Seeed-Projects/reBot-DevArm/README.md

<div align="center">

# 🦾 reBot Arm Base Series

**The Open-Source Robotic Arm for Every Developer**

reBot-DevArm Banner

<a href="https://certification.oshwa.org/cn000024.html">OSHWA Certified</a>








**100% Open Source · Embodied AI · Full Hardware + Software Stack**

🌐 [Landing Page](https://279070161-sketch.github.io/reBot/) · 📚 [Tutorial Center](https://wiki.seeedstudio.com/robotics_page/) · ▶ [Online Demo](https://seeed-projects.github.io/reBot_RS_Sim) · 🤖 [New: Bimanual reBot Arm T701](https://github.com/Seeed-Projects/reBot-Arm-T701)




[简体中文](README_zh.md) · [English](README.md) · [日本語](README_JP.md) · [français](README_Fr.md) · [Español](README_es.md)

</div>

---

## 📑 Contents

- [📖 Introduction](#-introduction)
- [🤖 Meet the Bimanual reBot Arm T701](#-meet-the-bimanual-rebot-arm-t701)
- [🛒 Get Your reBot Arm](#-get-your-rebot-arm)
- [🚀 Try the Online Simulation](#-try-the-online-simulation)
- [🗺️ Roadmap and Status](#%EF%B8%8F-roadmap-and-status)
- [⚙️ Hardware Specifications](#%EF%B8%8F-hardware-specifications)
- [🌟 Community Showcase](#-community-showcase)
- [🧹 Optional Hardware](#-optional-hardware)
- [🎓 Full-Stack Robotics Ecosystem](#-full-stack-robotics-ecosystem)
- [🙌 Acknowledgments and Contributors](#-acknowledgments-and-contributors)
- [📄 License](#-license)
- [☎ Contact Us](#-contact-us)

---

## 📖 Introduction

**reBot-DevArm** — the **reBot Arm B601-DM** and **reBot Arm B601-RS** — is a robotic arm project dedicated to lowering the barrier to learning Embodied AI. We believe in **true open source**: not just the code, but everything, released without reservation.

- 🦾 **Two arm models** — All design files for the **B601-DM (Damiao)** and **B601-RS (Robstride)**, two arms sharing the same appearance.
- 🛠️ **Hardware blueprints** — Source files for sheet-metal and 3D-printed parts.
- 🔩 **BOM list** — Detailed down to the spec and purchase link of every single screw.
- 💻 **Software & algorithms** — Python SDK, ROS1/2, Isaac Sim, LeRobot, and more.

## 🤖 Meet the Bimanual reBot Arm T701

<p align="center">
  <a href="https://github.com/Seeed-Projects/reBot-Arm-T701">reBot Arm T701 — open-source bimanual robotic platform</a>
</p>

After the B601, the community asked the obvious next question: *"Can it have two arms?"* The **[reBot Arm T701](https://github.com/Seeed-Projects/reBot-Arm-T701)** is our answer — an open-source bimanual platform for Physical AI, robot learning, and real-world data collection, carrying the B601's open-source legacy forward.

- 🦾 **Two 7-DOF arms + grippers on one torso** — One hand holds, the other operates.
- 📷 **Vision & compute ready** — Mounts for RealSense D405 wrist cameras, a D435 head camera, and a Jetson Orin.
- 🔓 **The same open-source promise** — CAD, BOM, SDK, and tutorials, released step by step.

> 🧪 The T701 is in **beta preview** and releasing in the open. ⭐ **[Star and watch the T701 repository](https://github.com/Seeed-Projects/reBot-Arm-T701)** to catch every release.

## 🛒 Get Your reBot Arm

| Model | Official Store | Other Channels |
| :--- | :--- | :--- |
| **reBot Arm B601-DM** | [SeeedStudio Bazaar](https://www.seeedstudio.com/reBot-Arm-B601-DM-Assembled-Kit-with-Power-Supply-Bundle.html) | [Amazon](https://www.amazon.com/dp/B0H2TWVFSW) · [AliExpress](https://de.aliexpress.com/item/1005012108314029.html) |
| **reBot Arm B601-RS** | [SeeedStudio Bazaar](https://www.seeedstudio.com/reBot-Arm-B601-RS-Bundle-p-6898.html) | [AliExpress](https://www.aliexpress.us/item/3256812343811970.html?gatewayAdapt=deu2usa4itemAdapt) |

### B601-DM Kit Options

Five kit options are available at [SeeedStudio.com](https://www.seeedstudio.com/reBot-Arm-B601-DM-Bundle.html):

- **[Arm Body Motor Kit](https://www.seeedstudio.com/reBot-Arm-B601-DM-Body-Motor-Kit-p-6752.html)** — Motors and wiring harnesses only.
- **[Arm Body Structural Kit](https://www.seeedstudio.com/reBot-Arm-B601-DM-Body-Structure-Kit-p-6753.html)** — Mechanical structural components only.
- **[Gripper Complete Kit](https://www.seeedstudio.com/reBot-Arm-B601-DM-Gripper-Kit-p-6751.html)** — Motors, wiring, and structure for the gripper.
- **[Full Kit](https://www.seeedstudio.com/reBot-Arm-B601-DM-Bundle.html)** — Complete arm body and gripper.
- **[Pre-assembled Robotic Arm](https://www.seeedstudio.com/reBot-Arm-B601-DM-Assembled-Kit-with-Power-Supply-Bundle.html)** — Fully assembled, ready to use.

> 💡 The kit does not include a power adapter or C-clamps as standard, since you may power it with batteries or mount it on a custom DIY base. Get the official [B601-DM Power Adapter Kit](https://www.seeedstudio.com/Power-Adapter-Kit-for-reBot-Arm-B601-DM-p-6874.html), purchase a [power supply](https://www.seeedstudio.com/AC-DC-Power-Adapter-IEC-60320-C14-XT30-Female-24V-4-5A-1200mm-L190-W92-5-H36mm-p-6764.html) and [power cord](https://www.seeedstudio.com/reServer-AC-US-p-5052.html) separately, or see the Mean Well solution at the bottom of the [BOM](./hardware/reBot_B601_DM/readme.md#about-power-supply).

### B601-RS Kit Options

Five kit options are available at [SeeedStudio.com](https://www.seeedstudio.com/reBot-Arm-B601-RS-Disassembly-Kit-Version-with-Power-Supply-Bundle.html):

- **[Arm Body Motor Kit](https://www.seeedstudio.com/reBot-Arm-B601-RS-Body-Motor-Kit-p-6867.html)** — Motors and wiring harnesses only.
- **[Arm Body Structural Kit](https://www.seeedstudio.com/reBot-Arm-B601-RS-Body-Structure-Kit-p-6866.html)** — Mechanical structural components only.
- **[Gripper Complete Kit](https://www.seeedstudio.com/reBot-Arm-B601-RS-Gripper-Kit-p-6868.html)** — Motors, wiring, and structure for the gripper.
- **[Full Kit](https://www.seeedstudio.com/reBot-Arm-B601-RS-Disassembly-Kit-Version-with-Power-Supply-Bundle.html)** — Unassembled complete arm body and gripper.
- **[Pre-assembled Robotic Arm](https://www.seeedstudio.com/reBot-Arm-B601-RS-Bundle-p-6898.html)** — Fully assembled, ready to use.

> 💡 We recommend the [Mean Well 48V 12.5A](https://www.amazon.com/sspa/click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) power supply for the RS model. For full performance, opt for a 48V 25A adapter. For a plug-and-play option, get the official [B601-RS Power Adapter Kit](https://www.seeedstudio.com/Power-Adapter-Kit-for-reBot-Arm-B601-RS-p-6873.html).

### Optional Accessories

Optional add-ons available at [SeeedStudio.com](https://www.seeedstudio.com):

- **[Power Adapter Kit (B601-DM)](https://www.seeedstudio.com/Power-Adapter-Kit-for-reBot-Arm-B601-DM-p-6874.html)** — Official power adapter for the DM model.
- **[Power Adapter Kit (B601-RS)](https://www.seeedstudio.com/Power-Adapter-Kit-for-reBot-Arm-B601-RS-p-6873.html)** — Official power adapter for the RS model.
- **[Power Discharge Module (B601-DM)](https://www.seeedstudio.com/Rebotic-Power-Discharge-Module-for-reBot-Arm-B601-DM-p-6988.html)** — Circuit protection and emergency stop for the DM model.
- **[Bleeder Module (B601-RS)](https://www.seeedstudio.com/Rebotic-Bleeder-Module-for-reBot-Arm-B601-RS-p-6987.html)** — Circuit protection and emergency stop for the RS model.
- **[Soft Gripper](https://www.seeedstudio.com/reBot-Soft-Gripper-p-6989.html)** — Flexible gripper compatible with both models.

### Leader Arm (Optional)

Purchase the [Leader Arm](https://www.seeedstudio.com/Star-Arm-102-p-6765.html?qid=P2U7IG_yskyak5m_1776415593315) and a [12V 10A power supply](https://www.seeedstudio.com/FY1209900-12V-10A-Power-Adapter-12V-10A-p-6496.html); the 12V DC adapter of the SO-ARM101 also works.

## 🚀 Try the Online Simulation

Experience the reBot Arm B601-RS MuJoCo digital twin directly in your browser — no installation required. Switch between the standard arm and AGV configurations, control joints and TCP, view the overhead and D405 wrist cameras, and run the automated put-away and stacking demos. The initial model download may take a moment; Chrome or Edge is recommended.

<p align="center">
  <a href="https://seeed-projects.github.io/reBot_RS_Sim"><strong>▶ Launch the reBot Arm Interactive Demo</strong></a>
</p>

## 🗺️ Roadmap and Status

We continuously maintain and adapt to mainstream robot development ecosystems. Below is our current progress and release plan.

### reBot Arm B601-DM

| Ecosystem | Status | Description | Documentation |
| :--- | :---: | :--- | :--- |
| Basic Motor Usage | ✅ Done | Motion control and API encapsulation | [Damiao Technology](https://wiki.seeedstudio.com/cn/damiao_series/) |
| STEP 3D Parts & BOM | ✅ Done | STEP files, parts BOM, and reference prices | [reBot Arm B601-DM BOM](./hardware/reBot_B601_DM/readme.md) |
| Real-Machine Performance Testing | ✅ Done | Performance under normal and extreme conditions | [Performance Testing](./hardware/reBot_B601_DM/performance_testing/Performance_Testing.md) |
| Assembly Video | ✅ Done | Ultra-detailed assembly steps and video | [Getting Started](https://wiki.seeedstudio.com/rebot_b601_dm_getting_started/) |
| Python SDK | ✅ Done | One-stop motor read/write & control (Robstride, Damiao, Mota, Gaoqing, Hexfellow…) | [Motorbridge](https://motorbridge.seeedstudio.com) · [Web UI](https://rebot-devarm.w0x7ce.eu/) |
| ROS2 Integration | ✅ Done | Kinematics, trajectory planning, gravity compensation | [ROS2 Guide](https://wiki.seeedstudio.com/rebot_arm_b601_dm_ros2_integration/) |
| Pinocchio Integration | ✅ Done | Forward/inverse kinematics and gravity compensation | [Pinocchio Guide](https://wiki.seeedstudio.com/rebot_arm_b601_dm_pinocchio_meshcat/) · [Repo](https://github.com/Seeed-Projects/reBotArm_control_py) |
| Isaac Sim Simulation | ✅ Done | USD models and simulated teleoperation | [Wiki](https://wiki.seeedstudio.com/rebot_arm_b601_dm_isaacsim/) |
| VR Teleoperation | ✅ Done | PICO 4 VR-based bilateral teleoperation | [Repo](https://github.com/Eaglewzw/lerobot-teleoperator-rebot-vr) |
| LeRobot Integration | ✅ Done | Hugging Face LeRobot training framework | [LeRobot Guide](https://wiki.seeedstudio.com/rebot_arm_b601_dm_lerobot/) |
| Depth Camera Integration | ✅ Done | YOLO + depth camera visual grasping demo | [Grasping Demo](https://wiki.seeedstudio.com/rebot_arm_b601_dm_grasping_demo/) |
| reSpeaker Voice Integration | ✅ Done | reSpeaker Flex 4-mic array, voice-driven control with spatial awareness | [Voice Control](https://wiki.seeedstudio.com/control_rebot_arm_using_voice_with_respeaker_flex/) |
| Latest Algorithms | ⏳ Planned | Mainstream algorithms updated progressively | Ongoing |
| Free Course Series | ⏳ Planned | A series of completely free courses | Ongoing |

#### Community Contributions

| Ecosystem | Author | Description | Repository |
| :--- | :---: | :--- | :--- |
| ROS2 (Humble), third-party integration, URDF / rebotarm_bringup | [@danieldoradotalaveron-rb](https://github.com/danieldoradotalaveron-rb) | 1. **Passive diagnostics monitor** (`rebotarm_monitor_ros2`) — `/diagnostics` overlay for `rqt_robot_monitor`, serial/CAN-aware aggregator;<br>2. **Safe park & shutdown** — capture rest pose on connect, slow return on shutdown or `/rebotarm/park`;<br>3. **Gravity compensation (smooth stop)** — MIT ramp-out to eliminate clack and jerk during pos/vel handoff;<br>4. **Gamepad teleop with IK/FK & safety** — end-effector control via IK, live RViz visualization (simulation-only test);<br>5. **D405 eye-in-hand TF** — Xacro under `end_link` for RViz visualization & TF only. | [rebotarm_monitor_ros2](https://github.com/danieldoradotalaveron-rb/rebotarm_monitor_ros2) · [reBotArmController_ROS2](https://github.com/danieldoradotalaveron-rb/reBotArmController_ROS2) |

### reBot Arm B601-RS

| Ecosystem | Status | Description | Documentation |
| :--- | :---: | :--- | :--- |
| Basic Motor Usage | ✅ Done | Motion control and API encapsulation | [Robstride](https://wiki.seeedstudio.com/cn/robstride_control/) |
| STEP 3D Parts & BOM | ✅ Done | STEP files, parts BOM, and reference prices | [reBot Arm B601-RS BOM](./hardware/reBot_B601_RS/README.md) |
| Getting Started | ✅ Done | Quick start for the B601-RS | [Getting Started](https://wiki.seeedstudio.com/rebot_b601_rs_getting_started/) |
| Assembly Video | ✅ Done | Ultra-detailed assembly steps and video | [Assembly Video](https://wiki.seeedstudio.com/rebot_b601_rs_getting_started/) |
| ROS2 (Humble) | ✅ Done | Kinematics, trajectory planning, gravity compensation, MoveIt2 | [ROS2 Guide](https://wiki.seeedstudio.com/rebot_arm_b601_rs_ros2_integration/) |
| LeRobot Integration | ✅ Done | Hugging Face LeRobot training framework | [LeRobot Guide](https://wiki.seeedstudio.com/rebot_arm_b601_rs_lerobot/) |
| Pinocchio Integration | ✅ Done | Forward/inverse kinematics and gravity compensation | [Pinocchio Guide](https://wiki.seeedstudio.com/rebot_arm_b601_rs_pinocchio_meshcat/) · [Repo](https://github.com/Seeed-Projects/reBotArm_control_py) |
| Depth Camera Integration | ✅ Done | YOLO + depth camera visual grasping demo | [Grasping Demo](https://wiki.seeedstudio.com/rebot_arm_b601_rs_grasping_demo/) |
| Embodied Agent Architecture | ✅ Done | Accepts natural-language commands (e.g. "pick up the red block"), auto-plans and executes grasping | [Design](https://wiki.seeedstudio.com/wrc_demo_tutorial/) · [Source](https://github.com/TheMoonAstronaut/wrc.git) |
| Isaac Sim Simulation | ✅ Done | USD models and simulated teleoperation | [DLI Course](https://www.seeedstudio.com/sim-to-real-with-seeed-rebot-and-nvidia-isaac) · [Repo](https://github.com/Seeed-Projects/reBot-Isaacsim) |
| Latest Algorithms | ⏳ Planned | Mainstream algorithms updated progressively | Ongoing |
| Free Course Series | ⏳ Planned | A series of completely free courses | Ongoing |

#### Community Contributions

| Ecosystem | Author | Description | Repository |
| :--- | :---: | :--- | :--- |
| iPhone, HEBI Mobile I/O and Meta Quest teleoperation | [@ammarjmahmood](https://github.com/ammarjmahmood) | Move a phone or a Quest controller and the gripper follows, using the relative pose mapping from TidyBot++ (CoRL 2024): native SwiftUI and ARKit iPhone app, HEBI Mobile I/O, WebXR passthrough on Quest, a 200 Hz MIT driver with gravity feedforward, IK on the official RS URDF and safety interlocks. Tested on a B601-RS with an iPhone 16 Pro Max. | [rebot-phone-teleop](https://github.com/ammarjmahmood/rebot-phone-teleop) |
| Handheld HMI, Zephyr RTOS / CAN / ROS 2 | [@xiayip](https://github.com/xiayip) | A handheld terminal for reBot Arm RS with live joint telemetry, encoder-based position control, damping/impedance modes, hand-guided trajectory recording and replay, persistent Flash storage, and ROS 2 controller-switch requests. | [reBot_Arm_HMI](https://github.com/xiayip/reBot_Arm_HMI) · [Video demo](https://www.bilibili.com/video/BV1MNnw6gEEe/) |

## ⚙️ Hardware Specifications

Designed for desktop Embodied AI applications, balancing payload and flexibility.

| Parameter | reBot Arm B601-DM | reBot Arm B601-RS |
| :--- | :--- | :--- |
| Payload | 1.5 kg | **2.5 kg** |
| Recommended Workspace | 70% of arm reach | 70% of arm reach |
| Max Reach | 767 mm | **754 mm** |
| Weight | **≈ 4.5 kg** | ≈ 6.7 kg |
| Repeatability | < ±0.2 mm | < ±0.1 mm |
| Degrees of Freedom | 6 DOF + 1 Gripper | 6 DOF + 1 Gripper |
| Supported Ecosystems | ROS1, ROS2, LeRobot, Pinocchio, Isaac Sim, Python SDK | ROS1, ROS2, LeRobot, Pinocchio, Isaac Sim, Python SDK |
| Supply Voltage | DC 24V | DC 48V |

## 🌟 Community Showcase

|  |  |  |  |  |
| :---: | :---: | :---: | :---: | :---: |
| <a href="https://www.kaggle.com/competitions/gemma-4-good-hackathon/writeups/new-writeup-1778618527713">GEM-4</a><br><sub>[GEM-4](https://www.kaggle.com/competitions/gemma-4-good-hackathon/writeups/new-writeup-1778618527713)</sub> | <a href="https://x.com/Linyan_Fu/status/2056383947341525180">Linyan Fu</a><br><sub>[Linyan Fu](https://x.com/Linyan_Fu/status/2056383947341525180) · [Apheth D Almeida](https://x.com/Apheth_DAlmeida/status/2053503164507476096)</sub> | <a href="https://x.com/DhruvDiddi/status/2046605015008383284">Dhruv Diddi</a><br><sub>[Dhruv Diddi](https://x.com/DhruvDiddi/status/2046605015008383284)</sub> | <a href="https://x.com/ed0henderson/status/2055076839002095743">Ed Henderson</a><br><sub>[Ed Henderson](https://x.com/ed0henderson/status/2055076839002095743)</sub> | Sameer<br><sub>Sameer</sub> |
| <a href="https://x.com/pham_blnh/status/2061994096374505710">Binh Pham</a><br><sub>[Binh Pham](https://x.com/pham_blnh/status/2061994096374505710)</sub> | <a href="https://www.instagram.com/reel/DY7Ny8OPjVu/?utm_source=ig_web_copy_link&igsh=NTc4MTIwNjQ2YQ==">FangTianChongHui</a><br><sub>[FangTianChongHui](https://www.instagram.com/reel/DY7Ny8OPjVu/?utm_source=ig_web_copy_link&igsh=NTc4MTIwNjQ2YQ==)</sub> | <a href="https://x.com/dong1505lin">Xense YaoLin Dong</a><br><sub>[Xense YaoLin Dong](https://x.com/dong1505lin)</sub> | <a href="https://x.com/ed0henderson/status/2055076839002095743">Ed Henderson</a><br><sub>[Ed Henderson](https://x.com/ed0henderson/status/2055076839002095743)</sub> | <a href="https://x.com/yoshikai_man/status/2079938975398244705">yoshikai_man</a><br><sub>[yoshikai_man](https://x.com/yoshikai_man/status/2079938975398244705)</sub> |
| <a href="https://github.com/lipengdong/hei-rebot-lift">hei-rebot-lift</a><br><sub>[hei-rebot-lift](https://github.com/lipengdong/hei-rebot-lift)</sub> | <a href="https://www.linkedin.com/posts/activity-7484390995862781952-TX4m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">Martin Kemka</a><br><sub>[Martin Kemka](https://www.linkedin.com/posts/activity-7484390995862781952-TX4m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)</sub> | <a href="https://www.linkedin.com/posts/kamil-buczy%C5%84ski-102843301_seeedstudio-rebotarm-seeedprojectofthemonth-ugcPost-7485297094715461633-RV_6/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">Kamil Buczyński</a><br><sub>[Kamil Buczyński](https://www.linkedin.com/posts/kamil-buczy%C5%84ski-102843301_seeedstudio-rebotarm-seeedprojectofthemonth-ugcPost-7485297094715461633-RV_6/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)</sub> | <a href="https://www.linkedin.com/posts/doradodaniel_computervision-spatialai-sim2real-share-7474727487374184448-NhwX/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">Daniel Dorado</a><br><sub>[Daniel Dorado](https://www.linkedin.com/posts/doradodaniel_computervision-spatialai-sim2real-share-7474727487374184448-NhwX/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)</sub> | <a href="https://www.linkedin.com/posts/asierarranz_nvidia-physicalai-isaaclab-ugcPost-7480271721942417408-YNwu/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">Asier</a><br><sub>[Asier](https://www.linkedin.com/posts/asierarranz_nvidia-physicalai-isaaclab-ugcPost-7480271721942417408-YNwu/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)</sub> |
| <a href="https://x.com/thermalpastor/status/2103842737032458567">H</a><br><sub>[H](https://x.com/thermalpastor/status/2103842737032458567)</sub> | <a href="https://x.com/Alpha10six/status/2103860758559994216">alpha_rover</a><br><sub>[alpha_rover](https://x.com/Alpha10six/status/2103860758559994216)</sub> | <a href="https://x.com/DilumSanjaya/status/2102806161728885145">Dilum Sanjaya</a><br><sub>[Dilum Sanjaya](https://x.com/DilumSanjaya/status/2102806161728885145)</sub> | <a href="https://x.com/pham_blnh/status/2101003855731593544">Binh</a><br><sub>[Binh](https://x.com/pham_blnh/status/2101003855731593544)</sub> | <a href="https://x.com/LeRobotHF/status/2104519372333048112">LeRobot</a><br><sub>[LeRobot](https://x.com/LeRobotHF/status/2104519372333048112)</sub> |
| <a href="https://x.com/raghav2956/status/2104659668375339475">Raghav Kumar</a><br><sub>[Raghav Kumar](https://x.com/raghav2956/status/2104659668375339475)</sub> | <a href="https://www.linkedin.com/posts/kamil-buczy%C5%84ski-102843301_seeedstudio-ai-agent-ugcPost-7510738285707776000-1SMQ/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">Kamil Buczyński</a><br><sub>[Kamil Buczyński](https://www.linkedin.com/posts/kamil-buczy%C5%84ski-102843301_seeedstudio-ai-agent-ugcPost-7510738285707776000-1SMQ/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)</sub> | <a href="https://www.linkedin.com/feed/update/urn:li:activity:7510701008885309440/">Fictionlab</a><br><sub>[Fictionlab](https://www.linkedin.com/feed/update/urn:li:activity:7510701008885309440/)</sub> | <a href="https://x.com/seeedstudio/status/2101965998954107303">box2bridge</a><br><sub>[box2bridge](https://x.com/seeedstudio/status/2101965998954107303)</sub> | <a href="https://x.com/seeedstudio/status/2095469352976003482">FangTianChongHui</a><br><sub>[FangTianChongHui](https://x.com/seeedstudio/status/2095469352976003482)</sub> |
| <a href="https://www.youtube.com/watch?v=hZRDGHnXDnk">Kamil Buczynski</a><br><sub>[Kamil Buczynski](https://www.youtube.com/watch?v=hZRDGHnXDnk)</sub> | <a href="https://gxchris95.github.io/BetaGo/">BetaGo</a><br><sub>[BetaGo](https://gxchris95.github.io/BetaGo/)</sub> | <a href="https://x.com/dimentary/status/2104094838035820607">Dmytro Hrybov</a><br><sub>[Dmytro Hrybov](https://x.com/dimentary/status/2104094838035820607)</sub> | <a href="https://x.com/aamarsbarr/status/2106242900426449204">Ammar</a><br><sub>[Ammar](https://x.com/aamarsbarr/status/2106242900426449204)</sub> | <a href="https://x.com/KlausPetersen_X/status/2110514809318023386">Klaus Petersen</a><br><sub>[Klaus Petersen](https://x.com/KlausPetersen_X/status/2110514809318023386)</sub> |
| <a href="https://dreamlabs.ai/playground/#sim">dreamlabs</a><br><sub>[dreamlabs](https://dreamlabs.ai/playground/#sim)</sub> | <a href="https://www.bilibili.com/video/BV1MNnw6gEEe/">追风少年Patrick</a><br><sub>[追风少年Patrick](https://www.bilibili.com/video/BV1MNnw6gEEe/)</sub> | <a href="https://www.bilibili.com/video/BV1zPnq6oEhm/">虾烤实验室</a><br><sub>[虾烤实验室](https://www.bilibili.com/video/BV1zPnq6oEhm/)</sub> | <a href="https://www.bilibili.com/video/BV1YRnH6qE8B/">Goat_wzz</a><br><sub>[Goat_wzz](https://www.bilibili.com/video/BV1YRnH6qE8B/)</sub> | <a href="https://www.bilibili.com/video/BV1Tipb6DEn5/">W_Love_D</a><br><sub>[W_Love_D](https://www.bilibili.com/video/BV1Tipb6DEn5/)</sub> |
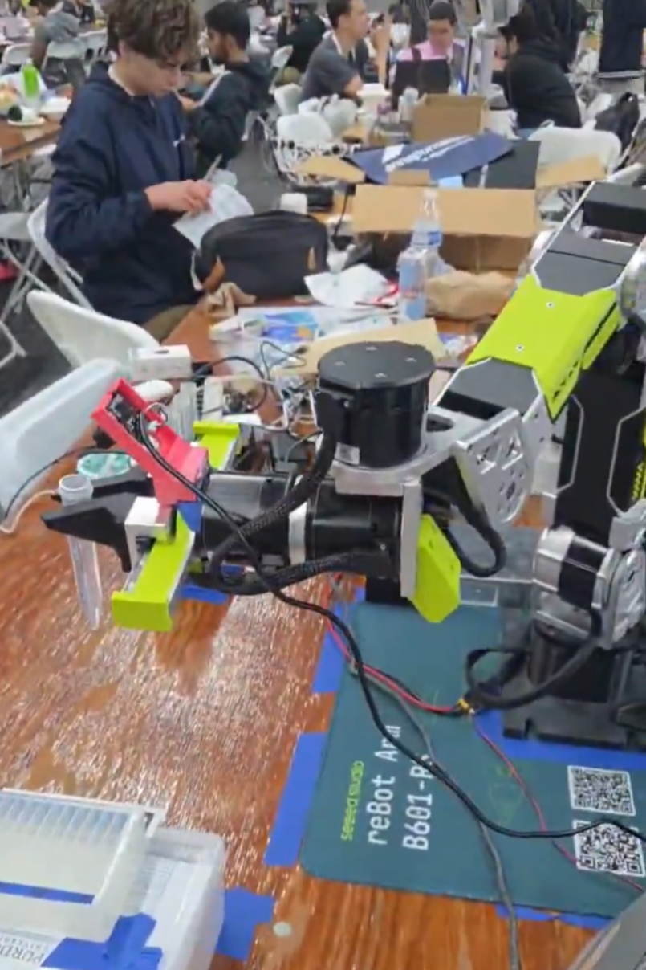
[picture p1: community/Amogh_Shrivastava.png]
Amogh Shrivastava
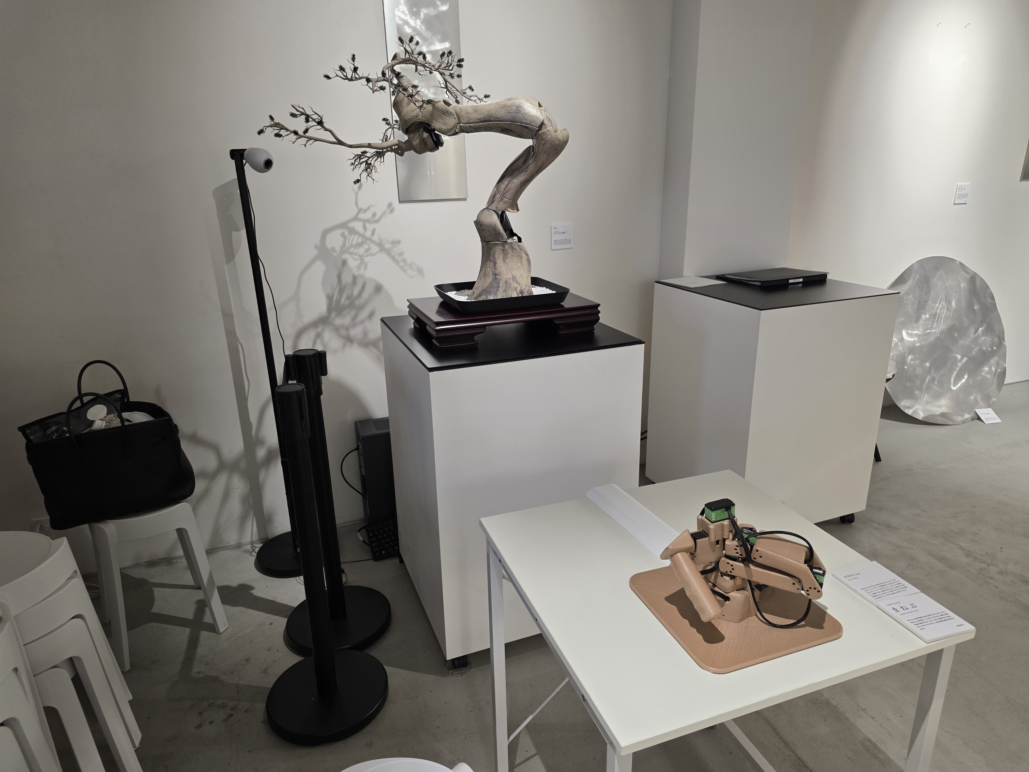
[picture p2: community/菊地あかね.jpg]
菊地あかね
| <a href="https://www.bilibili.com/video/BV1EvJR6iEuZ/">W_Love_D</a><br><sub>[W_Love_D](https://www.bilibili.com/video/BV1EvJR6iEuZ/)</sub> | <a href="https://x.com/yoshikai_man/status/2112946345548111958">yoshikai_man</a><br><sub>[yoshikai_man](https://x.com/yoshikai_man/status/2112946345548111958)</sub> | <a href="https://x.com/Mikeintech/status/2112604823170281688">Mike In Tech</a><br><sub>[Mike In Tech](https://x.com/Mikeintech/status/2112604823170281688)</sub> | <br><sub>[Amogh Shrivastava](https://x.com/stisov16/status/2114267861518868538)</sub> | <br><sub>[菊地あかね](https://x.com/akanekikuchi4/status/2078486766944928011)</sub> |

<p align="center">
  <a href="https://www.seeedstudio.com/sim-to-real-with-seeed-rebot-and-nvidia-isaac">Sim-to-Real VLA Course</a><br>
  <sub><a href="https://www.seeedstudio.com/sim-to-real-with-seeed-rebot-and-nvidia-isaac">Seeed reBot Arm × NVIDIA Isaac — Sim-to-Real VLA Course</a></sub>
</p>

## 🧹 Optional Hardware

### Wrist Camera Mount

These wrist camera mounts are shared by **B601-RS and B601-DM**. See the [complete camera mount and data collection catalog](hardware/camera-mounts/README.md) for all models, previews, and downloads.

| 32×32 UVC | Intel D435i | Intel D405 & Gemini 305 | Gemini 2 |
| :--- | :--- | :--- | :--- |
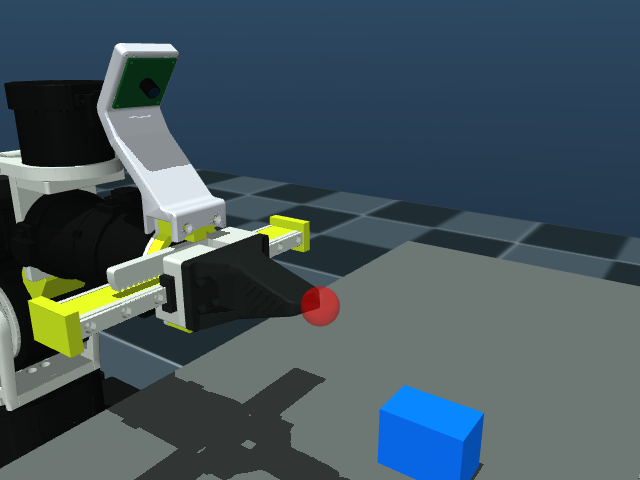
[picture p3: Rebot_Arm_description/Camera/images/uvc32-mujoco.png]
32×32 UVC MuJoCo wrist camera assembly
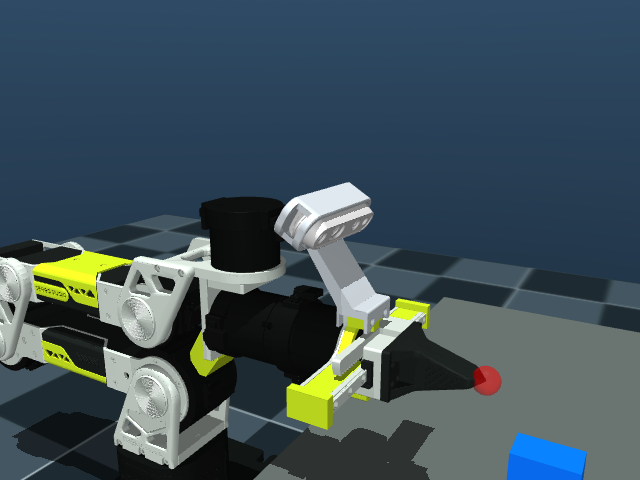
[picture p4: Rebot_Arm_description/Camera/images/d435i-mujoco.png]
RealSense D435i MuJoCo wrist camera assembly
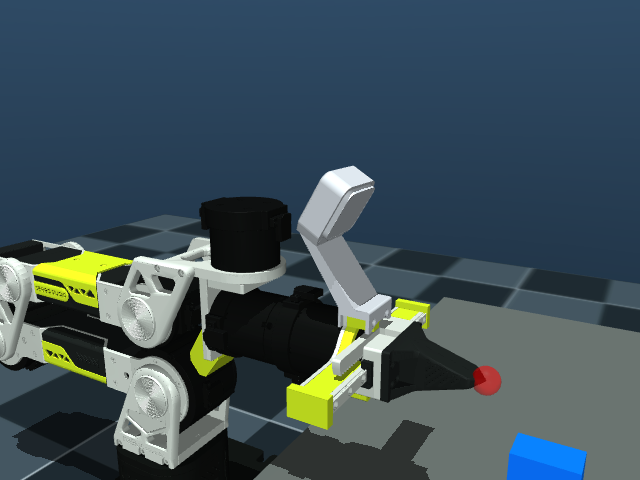
[picture p5: Rebot_Arm_description/Camera/images/d405-mujoco.png]
RealSense D405 MuJoCo wrist camera assembly
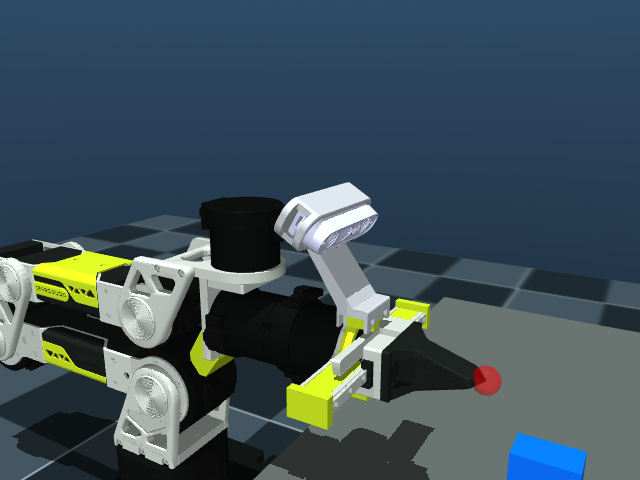
[picture p6: Rebot_Arm_description/Camera/images/gemini2-mujoco.png]
Orbbec Gemini 2 MuJoCo wrist camera assembly
|  |  |  |  |
| [STEP](hardware/camera-mounts/b601-camera-mounts/UVC32_mount.step) | [STEP](hardware/camera-mounts/b601-camera-mounts/D435_Gemini2_Mount.step) | [STEP](hardware/camera-mounts/b601-camera-mounts/D405_305_Mount.step) · [design notes](https://github.com/bowenszhu/rebot-b601-rs-d405-wrist-mount/tree/v1.0.0) | [STEP](hardware/camera-mounts/b601-camera-mounts/D435_Gemini2_Mount.step) |

The previews show UVC32, D435i, D405 and Gemini 2 assemblies on B601-RS; the mounts are shared with B601-DM. [URDFs and assembly instructions](Rebot_Arm_description/Camera/README.md). UVC32 uses the official bracket CAD with a schematic camera board.

### Leader Arm Compatibility

| Star Arm 102-LD | Open to compatibility integration |
| :--- | :--- |
|  | [Series Hub](https://fashionstar.com.hk/robot-arm/star-arm-102/) · [GitHub repo](https://github.com/servodevelop/Star-Arm-102) |

### DIY Soft Finger

| Soft Finger | Open to compatibility integration |
| :--- | :--- |
|  | Coming soon |
| [Finger Mount (ABS/PLA)](hardware/reBot_B601_DM/3D_Printed_Parts/Soft_Gripper/Soft_Gripper_Mount.step) · [Finger (TPU 95+)](hardware/reBot_B601_DM/3D_Printed_Parts/Soft_Gripper/Soft_Gripper_Finger.step) | Coming soon |
| Touch-Sensing Fin-Ray Gripper | **[Touch-Sensing Fin-Ray Gripper](https://github.com/StefanRohringer/Touch-Sensing-Fin-Ray-Gripper)** · [GitHub repo](https://github.com/StefanRohringer/Touch-Sensing-Fin-Ray-Gripper) |

### Recommended Optional Hardware

| Category | Type | Preview | Product | Link |
| :--- | :--- | :--- | :--- | :--- |
| **Camera** | Depth Camera | Orbbec Gemini 2 | **Orbbec Gemini 2 3D Camera** | [Seeed Studio](https://www.seeedstudio.com/Orbbec-Gemini-2-3D-Camera-p-6464.html) |
| **Camera** | Depth Camera | Orbbec Gemini 336 | **Orbbec Gemini 336 Depth Camera** | [Seeed Studio](https://www.seeedstudio.com/Orbbec-Gemini-336-3D-Camera-3D-p-6662.html) |
| **Camera** | Depth Camera | Orbbec Gemini 335LG | **Orbbec Gemini 335LG 3D Camera** | [Seeed Studio](https://www.seeedstudio.com/Orbbec-Gemini-335LG-3D-Camera-p-6541.html) |
| **Camera** | Depth Camera | SLAMTEC Aurora S | **SLAMTEC Aurora S** | [Seeed Studio](https://www.seeedstudio.com/SLAMTEC-Aurora-S-AI-Integrated-Spatial-Perception-System-p-6669.html) |
| **Camera** | Depth Camera | Intel RealSense D435i | **Intel RealSense Depth Camera D435i** | [Seeed Studio](https://www.seeedstudio.com/Intel-RealSense-Depth-Camera-D435i-p-4423.html) |
| **Camera** | Depth Camera | RealSense D405 | **RealSense Depth Camera D405** | [Seeed Studio](https://www.seeedstudio.com/RealSense-D405-3D-Camera-p-6758.html) |
| **Camera** | Monocular Camera | Sensing SG3S-ISX031C-GMSL2F | **Sensing SG3S-ISX031C-GMSL2F 3MP GMSL2 Camera** | [Seeed Studio](https://www.seeedstudio.com/SG3S-ISX031C-GMSL2F-p-6245.html) |
| **Camera** | Monocular Camera | ET-S231 | **ET-S231 Megapixel 120° Wide-Angle 1080P USB Camera** | [Seeed Studio](https://www.seeedstudio.com/ET-S231-120-USB-Camera-p-6683.html) |
| **Microphone** | Mic Array | reSpeaker Flex XVF3800 | **reSpeaker Flex XVF3800 Circular-4 with XIAO ESP32S3** | [Seeed Studio](https://www.seeedstudio.com/reSpeaker-Flex-XVF3800-Circular-4-with-XIAO-ESP32S3-p-6739.html) |
| **Microphone** | Mic Array | reSpeaker XMOS XVF3800 | **reSpeaker XMOS XVF3800** | [Seeed Studio](https://www.seeedstudio.com/ReSpeaker-XVF3800-USB-Mic-Array-p-6488.html) |
| **Controller** | Edge Controller | reComputer J3011 | **reComputer J3011-Orin Nano 8GB** | [Seeed Studio](https://www.seeedstudio.com/reComputer-J3011-p-5590.html) |
| **Controller** | Edge Controller | Jetson AGX Thor | **NVIDIA Jetson AGX Thor Developer Kit** | [Seeed Studio](https://www.seeedstudio.com/NVIDIA-Jetson-AGX-Thor-Developer-Kit-p-9965.html) |

## 🎓 Full-Stack Robotics Ecosystem

reBot-DevArm is not just a robotic arm — it is a robotics learning community. The following general tutorials are shared for free:

**🖥️ Edge Computing & Master Control**

-  — AI inference & compute core
-  — general Linux dev environment
-  — low-power wireless control node

**📡 Sensors & Peripherals**

- **Motors & Servos** — [Damiao / Gogo / Robstride / Mita / Feite / Fashion Star](https://wiki.seeedstudio.com/robotics_page/)
- **Visual Perception** — [Depth cameras / LiDAR / vision algorithms](https://wiki.seeedstudio.com/robotics_page/)
- **Voice Interaction** — [reSpeaker mic arrays / voice control / spatial awareness (DoA)](https://wiki.seeedstudio.com/control_rebot_arm_using_voice_with_respeaker_flex/)
- **Motion & Attitude** — [IMU (6/9-axis) / gyroscopes / magnetometers](https://wiki.seeedstudio.com/Sensor_accelerometer/)
- **Comprehensive Kits** — [more robotics sensors & driver examples](https://wiki.seeedstudio.com/robotics_page/)

> 👉 **[Enter the Wiki Knowledge Base](https://wiki.seeedstudio.com/)** — all tutorials are free to view.

## 🙌 Acknowledgments and Contributors

The path of open source is never lonely. The reBot-DevArm project would not exist without the support of Seeed Studio, the global open-source community, and our hardware partners.

**🌍 Ecosystem & Software Support**

- [Seeed Studio](https://www.seeedstudio.com/) — hardware supply chain and technical support
- [Hugging Face LeRobot](https://github.com/huggingface/lerobot) — end-to-end robot learning framework
- [NVIDIA Isaac Sim](https://developer.nvidia.com/isaac/sim) — robot simulation and synthetic data platform

**⚙️ Core Hardware Partners**

- [Damiao Technology](https://www.damiaokeji.com/)
- [Robstride](https://robstride.com/)
- [Fashion Star](https://fashionstar.com.hk/wiki/)

**💡 Inspiration**

- [SO-ARM100](https://github.com/TheRobotStudio/SO-ARM100/tree/main)
- [Mobile ALOHA](https://github.com/tonyzhaozh/aloha)
- [Dummy-Robot (Zhihui Jun)](https://github.com/peng-zhihui/Dummy-Robot)
- [OpenArm](https://openarm.dev/)
- [I2RT](https://i2rt.com/)
- [TRLC-DK1](https://github.com/robot-learning-co/trlc-dk1)

**🎃 Prototype Contributors**

- SeeedStudio AI Robotics Team — Yaohui Zhu (yaohui.zhu@seeed.cc)
- SeeedStudio STU — Wentao Dong
- SeeedStudio STU — Weiwei Xu
- SeeedStudio Purchasing Department — Fengqun Peng

**👥 Contributors**

<p align="center"><a href="https://github.com/Seeed-Projects/reBot-DevArm/graphs/contributors">
  
</a></p>

*Coming soon — welcome to submit PRs and become a contributor!*

### ⭐ Star History

<p align="center">
<picture>
  <source media="(prefers-color-scheme: dark)" srcset="assets/star-history/star-history-dark.svg">
  <source media="(prefers-color-scheme: light)" srcset="assets/star-history/star-history-light.svg">
  
</picture>
</p>

## 📄 License

- **Hardware Design** © 2026 Seeed Studio Co., Ltd. — open sourced under [CERN-OHL-W-2.0](https://ohwr.org/cern_ohl_w_v2.txt)
- **Firmware Code** © 2026 Seeed Studio Co., Ltd. — open sourced under [Apache-2.0](https://www.apache.org/licenses/LICENSE-2.0)

### Rights and Restrictions

The reBot Arm project has always followed the core philosophy of **agility, openness, responsibility, and symbiosis** to serve the developer community. Our vision is to let every enthusiast master the hardware architecture and software principles of robotic arms, and experience cutting-edge embodied-intelligence algorithms through reBot.

For the first five months after launch, the project used the **CC BY-SA NC (Non-Commercial)** license, so developers could focus on iterating and improving the product during its early phase. After months of polishing, **effective May 11, 2026**, the project transitioned to the **CERN-OHL-W 2.0** open-source license, achieving **100% full-stack open source (hardware and software) with full commercial-compliance and usage rights for all scenarios**.

Hardware and software use different licenses — please confirm the terms applicable to the part you use.

| Item | Hardware (CERN-OHL-W-2.0) | Software SDK (Apache-2.0) |
| :--- | :--- | :--- |
| ✅ Commercial Use | ✅ Allowed | ✅ Allowed |
| ✅ Modification | ✅ Allowed | ✅ Allowed |
| ✅ Redistribution | ✅ Allowed | ✅ Allowed |
| ✅ Closed-source Integration | ❌ Conditional (see [CERN-OHL-W-2.0](https://ohwr.org/cern_ohl_w_v2.txt)) | ✅ Allowed (no disclosure required) |
| ⚠️ Copyright Retention | ✅ Required | ✅ Required |
| ⚠️ License Text Retention | ✅ Required | ✅ Required |
| ⚠️ Modification Notice | ✅ Required (date + description) | ✅ Required (description) |
| ⚠️ Patent Grant | ✅ Explicit | ✅ Explicit |
| ⚠️ Source Provision on Distribution | ✅ Must provide "Complete Source" | ❌ Not required |
| ⚠️ External/Closed Module Compatibility | ✅ Allowed (Weakly Reciprocal) | ✅ Fully allowed |
| 🔗 Relation to Other Components | Independent interface modules (External Material) may stay closed | No restrictions |
| 📄 Official Full Text | [CERN-OHL-W-2.0](https://ohwr.org/cern_ohl_w_v2.txt) | [Apache-2.0](https://www.apache.org/licenses/LICENSE-2.0) |

## ☎ Contact Us

- **Open-Source Progress & Technical Support** — Yaohui: yaohui.zhu@seeed.cc
- **Future Collaboration & Customization** — Elaine: elaine.wu@seeed.cc
