Seeed-Projects/reBot-DevArm/hardware/reBot_B601_DM/readme_es.md

# 🤖 Especificación de hardware de código abierto de reBot DevArm

<p align="center">
  Banner de reBot-DevArm
</p>
<p align="center">
  <strong>
    <a href="./readme_zh.md">简体中文</a> &nbsp;|&nbsp;
    <a href="./readme.md">English</a> &nbsp;|&nbsp;
    <a href="./readme_jp.md">日本語</a>&nbsp;|&nbsp;
    <a href="./readme_fr.md">français</a>&nbsp;|&nbsp;
    <a href="./readme_es.md">Español</a>
  </strong>
</p>

| Fecha | Versión | Nombre del archivo | Registro de cambios |
|---|---|---|---|
|  2026-03-31 | v1.0 |  reBot_B601_DM_v1.0_20260331.step  | Subida inicial |
|  2026-04-25 | v1.1 |  reBot_B601_DM_v1.1_20260425.step  | Se añaden sujeciones de cables para los 3 motores de las articulaciones del extremo, para evitar que se aflojen y se desconecten. Se corrige el modelo de la articulación 1 de 4310 a 4340P. Se añade la pieza CNC 02_Base_Reinforcement_Part.step en la parte inferior para reforzar la rigidez de la base. |
|  2026-10-30 | v1.1 |  reBot_B601_DM_v1.1_20260625.step  | Todos los arneses de cables se han sustituido por arneses personalizados moldeados de mejor calidad; los dos soportes impresos en 3D del antebrazo y la muñeca se han ajustado internamente para que los cables puedan pasar por las posiciones de los orificios. |

Esta BOM corresponde al brazo robótico reBot Arm B601 DM, que utiliza motores de la serie 43 de Damiao. La otra versión, el reBot Arm B601 RS, utiliza motores RobStride; [consulta su BOM aquí](../reBot_B601_RS/README.md).

# 📦 Estructura de archivos
*   3D_Printed_Parts/: archivos STEP de todas las piezas impresas en 3D.
*   Metal_Parts/: archivos STEP de todas las piezas metálicas mecanizadas por CNC.
*   Purchased_Parts/: archivos STEP de todos los componentes comprados.
*   reBot_B601_DM_v1.1_20260625.step: archivo del ensamblaje completo del brazo robótico (versión actual).

# 🛒[Consigue todas las piezas](https://www.seeedstudio.com/reBot-Arm-B601-DM-Bundle.html)
- Ofrecemos cinco opciones de kit:
  - **Kit de motores del cuerpo del brazo**: incluye solo los motores y los arneses de cableado del brazo robótico.
  - **Kit estructural del cuerpo del brazo**: incluye solo los componentes estructurales mecánicos.
  - **Kit completo de la pinza (gripper)**: incluye los motores, los arneses de cableado y los componentes estructurales de la pinza.
  - **Kit completo**: incluye el conjunto completo del cuerpo del brazo robótico y la pinza.
  - **Brazo robótico premontado**: brazo robótico acabado y totalmente montado.

# 📊 Lista de materiales (BOM)

> [!WARNING]
> Aviso: la BOM publicada **no** representa la versión final que envía Seeed. Esta v1.1 de código abierto está optimizada para que los desarrolladores puedan reproducirla con el mínimo coste, con algunos detalles no esenciales simplificados.
> La versión final de producción de Seeed incluirá grabado láser en el metal para evitar errores de montaje (poka-yoke), algunas piezas impresas en 3D se sustituirán por metal para mayor durabilidad, las holguras y tolerancias de mecanizado se ajustarán a la variabilidad de fábrica (equilibrando precisión y coste) y se añadirá cableado personalizado (p. ej., protección con malla trenzada) con coste adicional. No obstante, la estructura mecánica es idéntica.

---

## 🖨️ Piezas impresas en 3D

| Descripción de la pieza | Imagen | Nombre del archivo | Material | Cant. | Notas |
|---|---|---|---|---|---|
| Plataforma base del brazo robótico |  | 01_BASE_Plate.step | ABS Bambu Lab negro | 1 | boquilla de 0.4 mm, altura de capa de 0.2 mm, relleno del 30% |
| Eslabón de la base del brazo robótico |  | 01_BASE_Link.step | ABS Bambu Lab negro | 1 | boquilla de 0.4 mm, altura de capa de 0.2 mm, relleno del 30% |
| Relleno izquierdo del brazo superior |  | 01_Upper_Arm_Fuller_L.step | PLA Bambu Lab negro y verde | 1 | boquilla de 0.4 mm, altura de capa de 0.2 mm, relleno del 15% |
| Relleno derecho del brazo superior |  | 01_Upper_Arm_Fuller_R.step | PLA Bambu Lab negro y verde | 1 | boquilla de 0.4 mm, altura de capa de 0.2 mm, relleno del 15% |
| Relleno central del brazo superior |  | 01_Upper_Arm_Fuller_M.step | ABS Bambu Lab negro | 1 | boquilla de 0.4 mm, altura de capa de 0.2 mm, relleno del 30% |
| Tope horizontal del brazo superior |  | 01_Upper_Arm_Limit.step | ABS Bambu Lab negro | 1 | boquilla de 0.4 mm, altura de capa de 0.2 mm, relleno del 30% |
| Asa del brazo |  | 01_Arm_Handle.step | ABS Bambu Lab negro | 1 | boquilla de 0.4 mm, altura de capa de 0.2 mm, relleno del 30% |
| Relleno izquierdo del brazo inferior |  | 01_Lower_Arm_Filler_L.step | PLA Bambu Lab negro y verde | 1 | boquilla de 0.4 mm, altura de capa de 0.2 mm, relleno del 15% |
| Relleno derecho del brazo inferior |  | 01_Lower_Arm_Filler_R.step | PLA Bambu Lab negro y verde | 1 | boquilla de 0.4 mm, altura de capa de 0.2 mm, relleno del 15% |
| Relleno central del brazo inferior |  | 01_Lower_Arm_Filler_M.step | ABS Bambu Lab negro | 1 | boquilla de 0.4 mm, altura de capa de 0.2 mm, relleno del 30% |
| Cubierta del brazo superior |  | 01_Upper_Arm_Cover.step | PLA Bambu Lab verde | 1 | boquilla de 0.4 mm, altura de capa de 0.2 mm, relleno del 15% |
| Cubierta del brazo inferior |  | 01_Lower_Arm_Cover.step | PLA Bambu Lab verde | 1 | boquilla de 0.4 mm, altura de capa de 0.2 mm, relleno del 15% |
| Cubierta de protección del motor 5 |  | 01_Motor_Cover.step | ABS Bambu Lab negro | 1 | boquilla de 0.4 mm, altura de capa de 0.2 mm, relleno del 30% |
| Tope horizontal de la pinza |  | 01_Lower_Arm_Limit.step | PLA Bambu Lab verde | 1 | boquilla de 0.4 mm, altura de capa de 0.2 mm, relleno del 15% |
| Soporte del carro de la pinza |  | 01-Rail-Bracket.step | PLA Bambu Lab verde | 1 | boquilla de 0.4 mm, altura de capa de 0.2 mm, relleno del 15% |
| Dedo de la pinza |  | 01_Finger.step | ABS Bambu Lab negro | 2 | boquilla de 0.4 mm, altura de capa de 0.2 mm, relleno del 45% |
| Sujeción de cables del motor 5 |  | 01_Joint5_Cable Restraint_A.step | PLA Bambu Lab verde | 1 | boquilla de 0.4 mm, altura de capa de 0.2 mm, relleno del 15% |
| Sujeción de cables A de los motores 6 y 7 |  | 01_Joint6_7_Cable Restraint_A.step | ABS Bambu Lab negro | 2 | boquilla de 0.4 mm, altura de capa de 0.2 mm, relleno del 30% |
| Sujeción de cables B de los motores 6 y 7 |  | 01_Joint6_7_Cable Restraint_B.step | ABS Bambu Lab negro | 2 | boquilla de 0.4 mm, altura de capa de 0.2 mm, relleno del 30% |
| - | Precio de referencia | Promedio **50 $** | | | El precio varía según el coste del material y el tiempo de impresión |

El roce continuado del arnés de cableado del motor 1 puede desgastar el conector del motor y provocar un mal contacto eléctrico. Imprimir las piezas que se indican a continuación puede mitigar este riesgo.

| Descripción de la pieza | Imagen | Nombre del archivo | Material | Cant. | Notas |
| ---- | ---- | ---- | ---- | ---- | ---- |
| Clips de arnés de cableado para ambos lados del motor 1 |  | `DM_Motor1_wiring_harness_clip.stp` | ABS Bambu Lab negro | 2 | boquilla de 0.4 mm, altura de capa de 0.2 mm, relleno del 30% |

## 📷 Soporte de cámara compatible

| Descripción de la pieza | Imagen | Nombre de archivo | Material | Cant. | Notas |
|---|---|---|---|---|---|
| [Orbbec Gemini2](https://www.seeedstudio.com/Orbbec-Gemini-2-3D-Camera-p-6464.html) |  | [`D435_Gemini2_Mount.step`](../camera-mounts/b601-camera-mounts/D435_Gemini2_Mount.step) | Bambu ABS Negro | 1 | Boquilla 0.4 mm, altura de capa 0.2 mm, relleno 30 % |

Los soportes de cámara de muñeca B601 son comunes a **B601-RS y B601-DM**. Los modelos, las vistas previas y las descargas están en el [catálogo compartido de soportes (en inglés)](../camera-mounts/README.md).

### 🧩 Recomendaciones de impresión
- Altura de capa: 0.2 mm
- Boquilla: 0.4 mm
- Soportes: añadir según sea necesario
- Materiales: las piezas sometidas a altas temperaturas y a carga se imprimen en ABS con un relleno del 30–80%; también pueden usarse nailon o materiales reforzados con fibra de carbono. Las piezas estéticas se imprimen en PLA con un relleno del 15%.
- Materiales recomendados para las piezas portantes: ABS con relleno del 30–80%, nailon o materiales reforzados con fibra de carbono

---

## 🔩 Piezas metálicas mecanizadas por CNC

> [!WARNING]
> Algunas piezas que pueden sustituirse por impresión 3D se indican en las notas, lo que puede reducir los costes considerablemente.

| Descripción de la pieza | Imagen | Nombre del archivo | Material | Cant. | Mecanizado | Notas |
|---|---|---|---|---|---|---|
| Soporte del rodamiento del motor 1 |  | 02_Base_Reinforcement_Part.step | Aleación de aluminio 5052 | 1 | CNC | Puede imprimirse en 3D en ABS con relleno alto para reducir el coste |
| Eje de rotación del motor 1 |  | 02_Arm_Yaw_Limit.step | Aleación de aluminio 5052 | 1 | CNC | Añade un límite de movimiento del ángulo de guiñada |
| Espaciador delantero de los motores 2–5 |  | 02_Motor_Front_Spacer.step | Aleación de aluminio 5052 | 4 | CNC | Puede imprimirse en 3D en ABS con relleno del 30% |
| Espaciador trasero de los motores 2–4 |  | 02_Motor_Back_Spacer.step | Aleación de aluminio 5052 | 3 | CNC | |
| Brida trasera de los motores 2–4 |  | 02_FLANGE.step | Aleación de aluminio 5052 | 3 | CNC | |
| Soporte del motor 5 de la muñeca |  | 02_Wrist_Bracket.step | Aleación de aluminio 5052 | 1 | CNC | |
| Conector A de la pinza |  | 02_Gripper_Connector_A.step | Aleación de aluminio 5052 | 1 | CNC | |
| Conector B de la pinza |  | 02_Gripper_Connector_B.step | Aleación de aluminio 5052 | 1 | CNC | |
| Soporte metálico del carro de la pinza |  | 02_Slider_Bracket.step | Aleación de aluminio 5052 | 1 | CNC | Puede imprimirse en 3D en ABS con relleno alto; no recomendado para uso prolongado |
| Extensión del carro a la pinza |  | 02_Slider_Extension.step | Aleación de aluminio 5052 | 2 | CNC | |
| Eslabón izquierdo entre brazo superior e inferior |  | 02_Lower_Upper_Link_L.step | Aleación de aluminio 5052 | 1 | CNC | |
| Eslabón derecho entre brazo superior e inferior |  | 02_Lower_Upper_Link_R.step | Aleación de aluminio 5052 | 1 | CNC | |
| Eslabón izquierdo entre brazo inferior y muñeca |  | 02_Lower_Wrist_Link_L.step | Aleación de aluminio 5052 | 1 | CNC | |
| Eslabón derecho entre brazo inferior y muñeca |  | 02_Lower_Wrist_Link_R.step | Aleación de aluminio 5052 | 1 | CNC | |
| Conector del engranaje |  | 02_Gear_Connector.step | Aleación de aluminio 5052 | 1 | CNC | |
| Cremallera |  | 02_Rack.step | Aleación de aluminio 5052 | 2 | CNC | |
| Eslabón 1 |  | 03_Link1.step | Aleación de aluminio 5052 | 1 | CNC + chapa metálica | |
| Eslabón 2 |  | 03_Link2.step | Aleación de aluminio 5052 | 2 | CNC + chapa metálica | |
| Eslabón 3 izquierdo |  | 03_Link3_L.step | Aleación de aluminio 5052 | 1 | CNC + chapa metálica | |
| Eslabón 3 derecho |  | 03_Link3_R.step | Aleación de aluminio 5052 | 1 | CNC + chapa metálica | |
| Eslabón 5 |  | 03_Link5.step | Aleación de aluminio 5052 | 1 | CNC + chapa metálica | |
| - | Precio de referencia de mercado | Promedio **250 $** | | | El precio varía según el coste del aluminio, los requisitos de tolerancia y el plazo de entrega |

### 🧩 Especificaciones de mecanizado
- Tolerancia de las cotas clave: ±0.02 mm GB/T1840-M
- Acabado superficial: anodizado / arenado
- Se recomienda usar H7 / ajuste por interferencia en las piezas de acoplamiento
---

## 🛒 Piezas compradas (piezas estándar)

> [!WARNING]
> Dado que cada uno tendrá que montar y apretar los tornillos por su cuenta, se han elegido tornillos Allen estándar. Tras un funcionamiento prolongado, los tornillos pueden aflojarse, lo que afectará a la precisión del brazo robótico. Por este motivo, debes comprar adicionalmente pegamento termofusible para fijar las roscas de los tornillos de cada articulación.

Si tienes un taladro eléctrico o herramientas similares, puedes optar por comprar arandelas de bloqueo o tornillos con freno de rosca. No obstante, **es sumamente importante** que uses el ajuste de par más bajo al utilizar un atornillador eléctrico para evitar que los tornillos se pasen de rosca, lo que provocaría daños irreversibles.

  | Nombre | Especificación / Modelo | Cantidad | Precio de referencia | Notas |
  |------|----------|------|----------|------|
  | Motor sin escobillas | DM4310(V4) | 4 | 120 $/unidad | [SeeedStudio](https://www.seeedstudio.com/Damiao-4310-Actuator-Motor-p-6823.html) |
  | Motor sin escobillas | DM4340P(V4) | 3 | 175 $/unidad |  [SeeedStudio](https://www.seeedstudio.com/DM4340P-Actuator-p-6663.html)  |
  | Placa driver CAN-USB |  | 1 | 15 $/unidad |   [SeeedStudio](https://www.seeedstudio.com/DM-CAN-USB-Driver-Borad-p-6706.html)   |
  | Rodamiento | 6707ZZ | 1 | 13 $/unidad | [Amazon](https://www.amazon.com/uxcell-35x44x5mm-Shielded-Precision-Lubricated/dp/B0D6WBMW3F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) |
  | Rodamiento | 6803ZZ | 3 | 13 $/unidad | [Amazon](https://www.amazon.com/uxcell-17x26x5mm-Shielded-Precision-Lubricated/dp/B0D54JSWBZ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) |
  | Rodamiento | AXK5578 | 1 | 12 $/unidad | [Amazon](https://www.amazon.com/PZRT-AXK5578-Thrust-Bearings-Washers/dp/B0B3M3RZGW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) |
  | Guía lineal | MGN9-170mm | 1 | 23 $/unidad | [Amazon](https://www.amazon.com/uxcell-Sliding-Carriage-Bearing-Printers/dp/B0D54L45WM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) |
  | Carro | MGN9 | 2 | 10 $/unidad | [Amazon](https://www.amazon.com/uxcell-Bearing-Sliding-Carriage-Anti-Fall/dp/B0D9QBQDKB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) |
  | Engranaje | Módulo 1, tipo cubo, 16 dientes, agujero de 6 mm | 1 | 44 $/unidad | [Amazon](https://www.amazon.com/Module-15-Teeth-Finished-Perforation/dp/B0GDSR1LKM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)  |
  | Almohadilla de silicona | 30x9x2mm | 1 | 10 $ | [Amazon](https://www.amazon.com/Self-Adhesive-Anti-Sliding-Anti-Scratch-Protectors-Appliances/dp/B0F9KVYXFZ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) |
  | Tornillo | Tornillo HM3-12mm | 14+ |  | [Amazon](https://www.amazon.com/BNUOK-120pcs-Stainless-Threads-Spanner/dp/B0DJQGMQZM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) |
  | Tornillo | Tornillo HM3-25mm | 14+ |  | [Amazon](https://www.amazon.com/BNUOK-120pcs-Stainless-Threads-Spanner/dp/B0DJQFGRPQ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)  |
  | Tornillo | Tornillo HM3-6mm | 16+ |  | [Amazon](https://www.amazon.com/BNUOK-120pcs-Stainless-Threads-Spanner/dp/B0DJQG5YLF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)  |
  | Tornillo | Tornillo prisionero HM4-75mm | 4+ |  | [Amazon](https://www.amazon.com/iexcell-Partially-Threaded-Thread-Socket/dp/B0DR1NX178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)  |
  | Tornillo | Tornillo KM3*12mm | 30+ |  |  [Amazon](https://www.amazon.com/Uxcell-a16011300ux0872-M3x12mm-Carbon-Countersunk/dp/B01E6EIC2S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) |
  | Tornillo | Tornillo KM3*16mm | 34+ |  | [Amazon](https://www.amazon.com/Uxcell-a16011300ux0872-M3x12mm-Carbon-Countersunk/dp/B01E6EIC2S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)  |
  | Tornillo | Tornillo KM3*7mm | 76+ |  |[Amazon](https://www.amazon.com/Uxcell-a16011300ux0872-M3x12mm-Carbon-Countersunk/dp/B01E6EIC2S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)   |
  | Tornillo | Tornillo KM3*9mm | 31+ |  |[Amazon](https://www.amazon.com/Uxcell-a16011300ux0872-M3x12mm-Carbon-Countersunk/dp/B01E6EIC2S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)   |
  | Tornillo | Tornillo KM3*8mm de cabeza baja con hueco hexagonal (Socket Micro Profile Head) | 31+ |  |[Amazon](https://www.amazon.com/SMALLRIG-Screw-Screws-12pcs-Pack/dp/B01MS60KSY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)   |
  | Tornillo | KA3*12mm | 72+ |  | [Amazon](https://www.amazon.com/uxcell-Phillips-Tapping-Screws-Silver/dp/B01MXSS95N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)  |
  | Pasador cilíndrico | M4*8mm | Varios |  | [Amazon](https://www.amazon.com/HARFINGTON-Stainless-Cylindrical-Furniture-Installation/dp/B0F6CWL4MP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)  |
  | Pasador cilíndrico | M4*12mm | Varios |  | [Amazon](https://www.amazon.com/HARFINGTON-Stainless-Cylindrical-Furniture-Installation/dp/B0F6CWL4MP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)  |
  | Juego de destornilladores | Juego de llaves hexagonales | 1 | 16 $  | [Amazon](https://www.amazon.com/Amazon-Basics-Ratcheting-Electronics-Screwdriver/dp/B07V4TFWFZ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)  |
  |  | XT30 2+2 350mm | 2 | 4 $/cable | Ambos extremos en ángulo |
  |  | XT30 2+2 350mm | 1 | 4 $/cable | Un extremo en ángulo y otro recto |
  |  | XT30 2+2 200mm | 3 | 4 $/cable | Ambos extremos en ángulo |
  |  | XT30 2+2 200mm | 1 | 3 $/cable | Ambos extremos rectos |

### Sobre la fijación
Puedes modificar libremente la base a partir de las piezas impresas en 3D que proporcionamos. También puedes usar sargentos en G según el grosor de tu mesa.

  | Nombre | Especificación / Modelo | Cantidad | Precio de referencia | Notas |
  |------|----------|------|----------|------|
  | Sargento de carpintería | Sargento en G de 6 pulgadas | 2 | 20 $/unidad | [Amazon](https://www.amazon.com/gp/aw/d/B092J1YW2M/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) |

### Sobre la alimentación
El brazo robótico se envía por defecto sin fuente de alimentación. Puedes conectar tu propia batería o comprar una fuente de alimentación MeanWell fiable de 24V 14.6A fabricada en Taiwán. Además, necesitarás comprar un enchufe de tres clavijas conforme a la normativa local y un arnés de cableado con conector XT30 hembra.

#### BOM de consumibles

| Nombre | Especificación | Cant. | Precio de referencia | Notas | Imagen |
|:---|:---|:---:|:---:|:---|:---:|
| Fuente de alimentación | LRS-350-24 (24V 14.6A) | 1 | 27.35 $ | [amazon](https://www.amazon.com/MEAN-WELL-LRS-350-24-350-4W-Switchable/dp/B013ETVO12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) |  |
| Cable de alimentación | Cable de CA estándar de EE. UU. | 1 | 4.49 $ | [amazon](https://www.amazon.com/LIFEPOE-Power-3-3ft-Black-3-Prong/dp/B0FK4KPW2G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) |  |
| Puerto de salida | Conector hembra fijo XT60E; XT60E hembra + terminal de ojal - 10cm; orificio del terminal de 4mm | 1 | 9.99 $ | [amazon](https://www.amazon.com/LINSYRC-XT60E-F-Connector-Battery-Quadcopter/dp/B0CQK1P1DP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) |  |
| Cableado de CA | 1.5mm²; rojo, azul y amarillo, 1 de cada (debes crimpar tú mismo los terminales al cable; no se incluyen cables precrimpados); 10CM | 3 | 0.99 $ | [aliexpress](https://www.aliexpress.com/item/1005008648016252.html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) |  |
| Base IEC 3 en 1 | Tipo de conexión rápida con interruptor rojo (doble tuerca) | 1 | 1.98 $ | [aliexpress](https://www.aliexpress.com/item/1005005962021242.html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) |  |
| Cable adaptador XT30 a XT60 | XT30U hembra a XT60 macho | 1 | 8.99 $ | [amazon](https://www.amazon.com/dp/B0BY8PSHK6?th=1) |  |
| Tornillo avellanado Phillips de acero inoxidable 304 | M4x6 | 6 | 0.37 $ | / | / |
| Tornillo avellanado Phillips de acero inoxidable 304 | M3x8 | 2 | 0.36 $ | / | / |
| Tornillo Phillips de cabeza alomada de acero inoxidable 304 | M3x8 | 2 | 0.32 $ | / | / |
| Tuerca hexagonal | M3x2.5 | 2 | ≈0.30 $ | / | / |

#### BOM de piezas impresas

| Nombre | Imagen | Cant. | Notas |
|:---|:---|:---:|:---|
| [Carcasa frontal](./3D_Printed_Parts/DM-power-Top%20Cover.stp) |  | 1 | PLA, boquilla de 0.4 mm, altura de capa de 0.2 mm, relleno del 30% |
| [Carcasa trasera](./3D_Printed_Parts/DM-power-Bottom%20Cover.stp) |  | 1 | PLA, boquilla de 0.4 mm, altura de capa de 0.2 mm, relleno del 30% |
| [Tapa deslizante de la carcasa frontal](./3D_Printed_Parts/DM-power-Top%20Cover-Sliding%20Cover.stp) |  | 1 | PLA, boquilla de 0.4 mm, altura de capa de 0.2 mm, relleno del 30% |

#### Montaje de la fuente de alimentación

El montaje de la fuente de alimentación se divide en dos secciones principales: la carcasa frontal y la carcasa trasera.

##### 1. Montaje de la carcasa frontal

| Paso | Instrucciones | Imagen | Notas |
|:---:|---|---|---|
| 1-1 | Prepara las piezas y los componentes impresos necesarios para el montaje de la carcasa frontal |  | Comprueba que todas las piezas estén completas |
| 1-2 | Consulta las indicaciones de la secuencia de cableado de cada pieza y monta siguiéndola | <br> | Sigue estrictamente la secuencia de cableado al conectar |
| 1-3 | Instala el conector XT60 |  | Fíjalo con tornillos avellanados Phillips de acero inoxidable 304 M3x8 y tuercas hexagonales M3x2.5 |
| 1-4 | Instala la base IEC 3 en 1 |  | Fija la base IEC 3 en 1 con tornillos Phillips de cabeza alomada de acero inoxidable 304 M3x8 |
| 1-5 | Cableado interno de la carcasa frontal | <br> | Comprueba las conexiones con el diagrama de la secuencia de cableado |
| 1-6 | Fija ambos lados de la carcasa frontal y la fuente de alimentación |  | Tornillos avellanados Phillips de acero inoxidable 304 M4x6 x2 |
| 1-7 | Instala la tapa deslizante |  | Introdúcela desde la parte inferior de la fuente de alimentación |
| 1-8 | Fija la tapa deslizante |  | Tornillos avellanados Phillips de acero inoxidable 304 M4x6 x2 |

---

##### 2. Montaje de la carcasa trasera

| Paso | Instrucciones | Imagen | Notas |
|:---:|---|---|---|
| 2-1 | Prepara las piezas y los componentes impresos necesarios para el montaje de la carcasa trasera |  | Comprueba que los accesorios estén completos |
| 2-2 | Monta la carcasa trasera con la fuente de alimentación |  | Alinea la posición |
| 2-3 | Fija ambos lados de la carcasa trasera y la fuente de alimentación |  | Tornillos avellanados Phillips de acero inoxidable 304 M4x6 x2 |

---

##### 3. Finalización del conjunto

| Paso | Instrucciones | Imagen | Notas |
|:---:|---|---|---|
| 1 | Montaje del sistema de alimentación completado |  | Comprueba que todos los tornillos estén apretados |

---
