Seeed-Projects/reBot-DevArm/hardware/camera-mounts/b601-camera-mounts/V1/D435_Gemini2_Mount.step

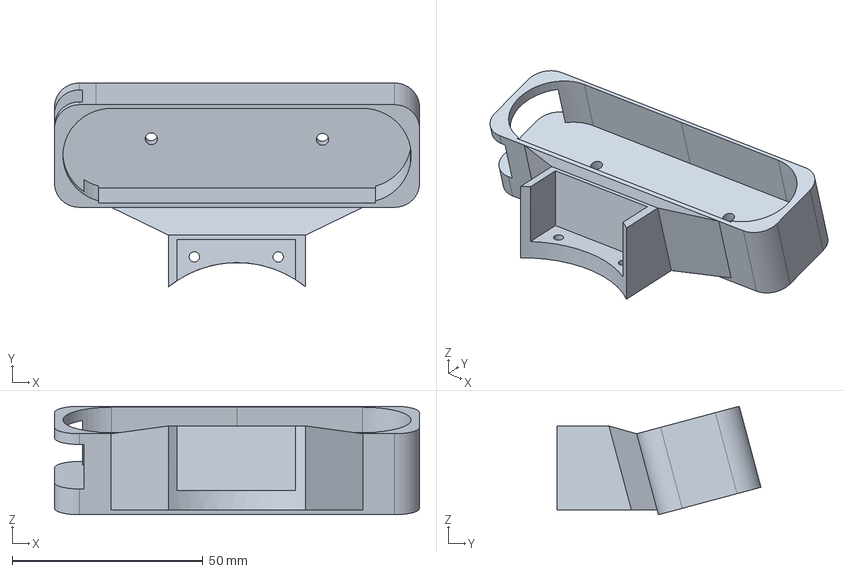
[picture p13: CAD file, 2026-11-11]
hardware/camera-mounts/b601-camera-mounts/V1/D435_Gemini2_Mount.step
95.8 x 53.5 x 28.5 mm
