Seeed-Projects/reBot-DevArm/hardware/camera-mounts/data-collection-camera-mounts/data-collection-camera-mount-v2.stp

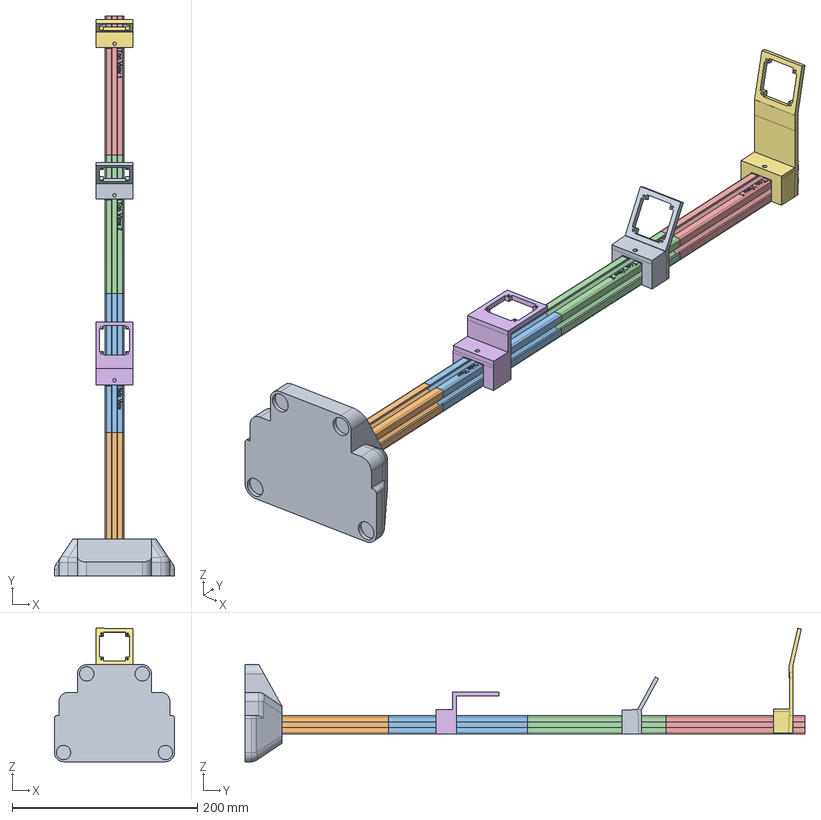
[picture p14: CAD file, 2026-10-09]
hardware/camera-mounts/data-collection-camera-mounts/data-collection-camera-mount-v2.stp
130.0 x 605.0 x 144.3 mm
4_2020_150MM0001
3_2020_150MM0001
2_2020_150MM0001
1_2020_150MM0001
