Seeed-Projects/reBot-DevArm/hardware/camera-mounts/data-collection-camera-mounts/V1/mount-1.stp

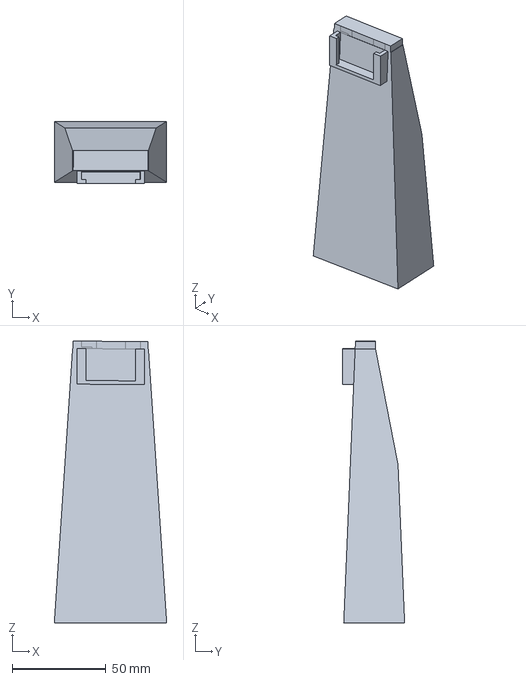
[picture p15: CAD file, 2026-10-09]
hardware/camera-mounts/data-collection-camera-mounts/V1/mount-1.stp
60.0 x 33.2 x 150.5 mm
