Seeed-Projects/reBot-DevArm/hardware/reBot_B601_DM/reBot_B601_DM_v1.1_20260625.step

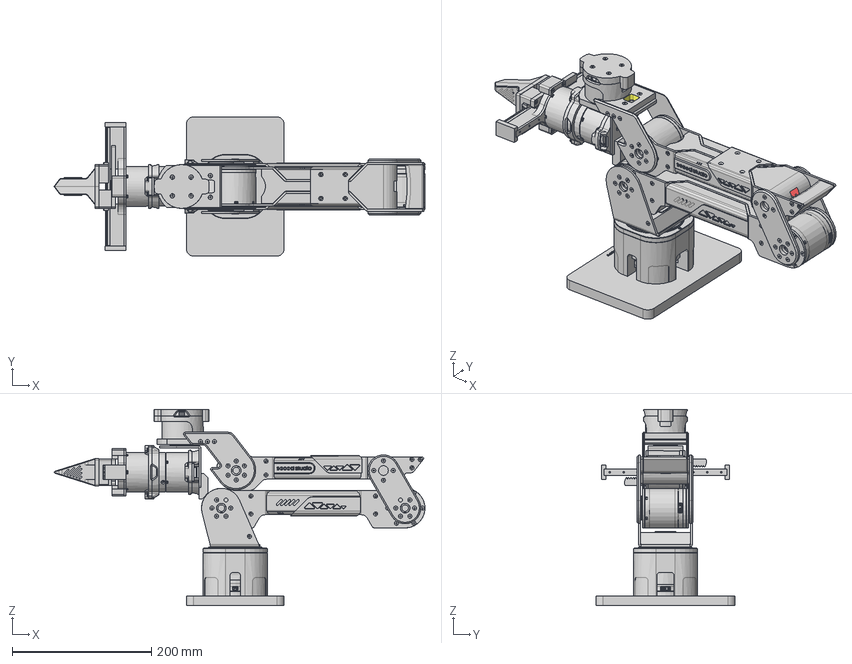
[picture p16: CAD file, 2026-10-30]
hardware/reBot_B601_DM/reBot_B601_DM_v1.1_20260625.step
532.8 x 200.0 x 282.2 mm
7-KA3-12 x 60
7-KM3-12 x 22
6-BEARING-OD26ID17H5 x 3
6-SILICONE-L30W9H2 x 2
7-PIN-D4L14 x 3
7-KM3-16 x 26
2-U-PLATE-1
2-M1-ROTOR-1
2-SHAFT-SLEEVE-ROTATOR-1 x 4
2-SHAFT-SLEEVE-STATOR-1 x 3
1-SPACE-1
7-PIN-D4L10 x 6
7-KM3-7 x 64
7-KM3-9 x 34
DM-J4340P x 3
2-LINK-1-ARM x 2
2-SPACE-STATOR-1 x 3
1-DOWN-COVER
1-DOWN-DECORATION-L
1-SPACE-DOWN
1-DOWN-DECORATION-R
7-PIN-D4L7 x 6
DM-J4310 x 4
2-LINK-2-ARM-R
1-LINK-2-ARM-L
2-CONNECTING-ROD-1-L
2-CONNECTING-ROD-1-R
1-UP-DECORATION-L
1-HANDLE
1-UP-DECORATION-R
1-UP-COVER
2-CONNECTING-ROD-2-L
2-CONNECTING-ROD-2-R
1-WIRE-SLIP-COVER-1
1-WIRE-CLIP-1
1-WIRE-CLIP-2 x 2
2-M7-STATOR
2-M6-ROTOR
7-HM3-6 x 8
7-HM3-12 x 7
1-BASE-PLATE-1
1-BASE-UP-1
6-THRUST-BEARING-OD78ID55H5
6-BEARING-OD44ID35H5
7-PIN-D3L8 x 2
7-KM3-8-XIAO x 5
7-HM4-75 x 4
2-M1-STATOR-1
2-M5-ROTOR-L
1-SPACE-2
7-HM3-25 x 6
7-S-M4-5-JIMI x 2
6-RAIL-170
6-SLIDER x 2
5-GEAR-1M16C
2-SLIDER-FIX x 2
2-RACK-1M x 2
2-RAIL-BASE-1
2-M7-ROTOR
1-RAIL-BASE-2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
