Seeed-Projects/reBot-DevArm/Rebot_Arm_description/Camera/meshes/gemini2/camera_infra2_optical_frame.STL

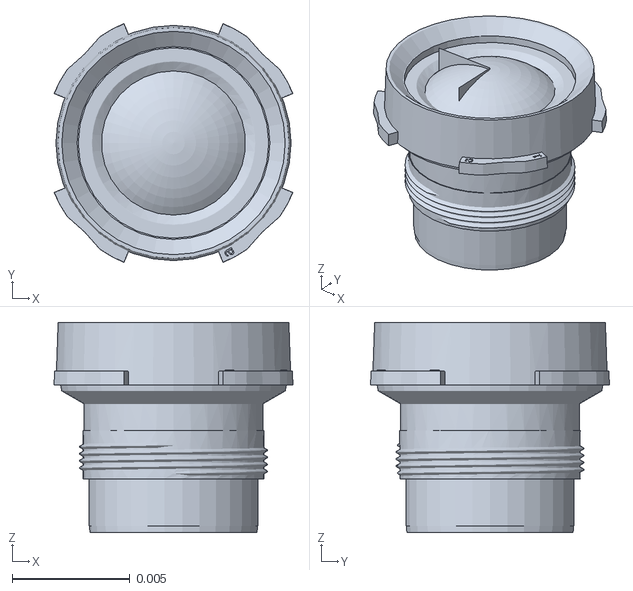
[picture p17: CAD file, 2026-10-09]
Rebot_Arm_description/Camera/meshes/gemini2/camera_infra2_optical_frame.STL
0.0102 x 0.0102 x 0.00895
