Seeed-Projects/reBot-DevArm/Rebot_Arm_description/Camera/meshes/mounts/UVC32_mount.stl

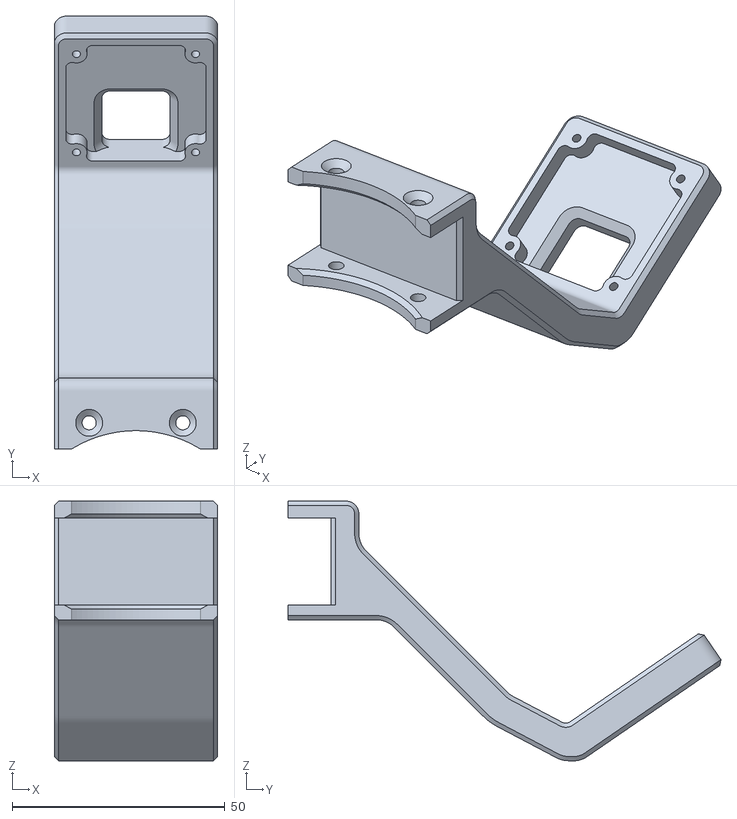
[picture p18: CAD file, 2026-10-09]
Rebot_Arm_description/Camera/meshes/mounts/UVC32_mount.stl
38.4 x 101.7 x 61.0
