Seeed-Projects/reBot-DevArm/Rebot_Arm_description/Camera/meshes/realsense/d405.stl

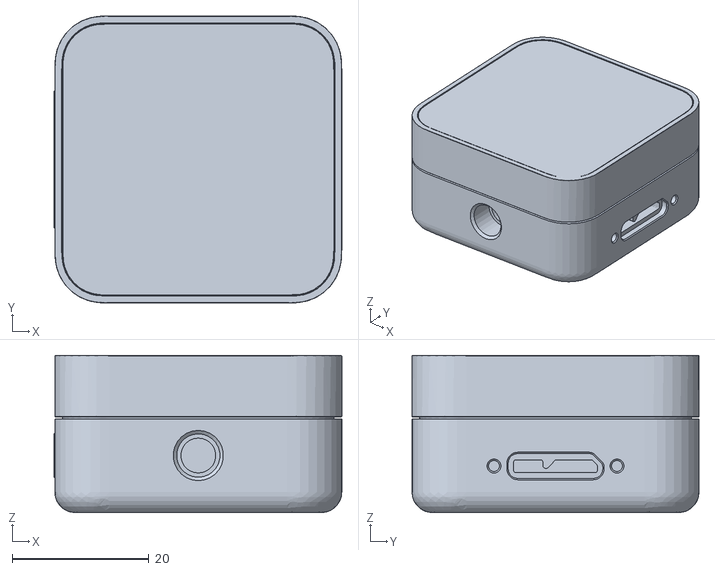
[picture p19: CAD file, 2026-10-09]
Rebot_Arm_description/Camera/meshes/realsense/d405.stl
42.1 x 42.0 x 23.0
