Seeed-Projects/reBot-DevArm/Rebot_Arm_description/Camera/meshes/uvc32/glass.stl

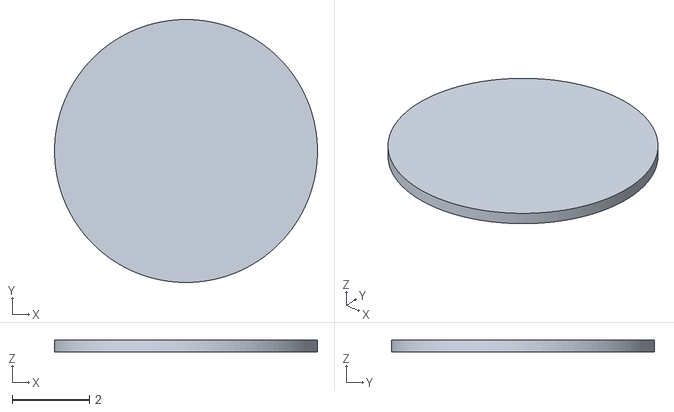
[picture p20: CAD file, 2026-10-09]
Rebot_Arm_description/Camera/meshes/uvc32/glass.stl
6.80 x 6.80 x 0.3
