Seeed-Projects/reBot-DevArm/hardware/camera-mounts/b601-camera-mounts/V1/D405_305_Mount.step

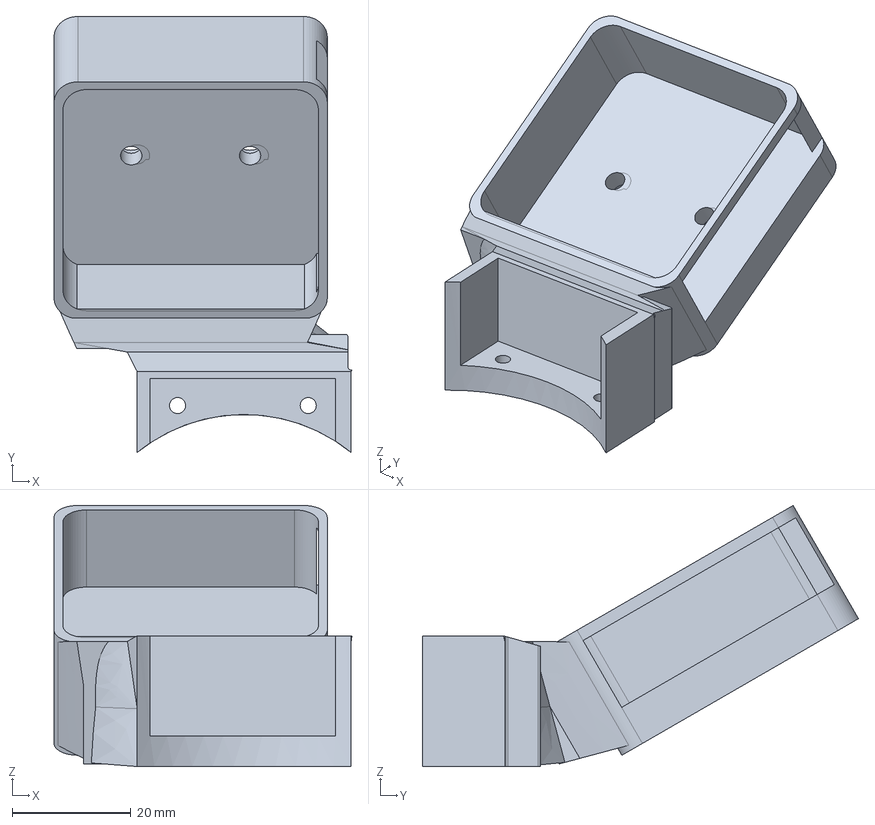
[picture p21: CAD file, 2026-11-11]
hardware/camera-mounts/b601-camera-mounts/V1/D405_305_Mount.step
50.1 x 73.4 x 43.9 mm
