Seeed-Projects/reBot-DevArm/hardware/camera-mounts/data-collection-camera-mounts/V1/mount-3-4-adapter.stp

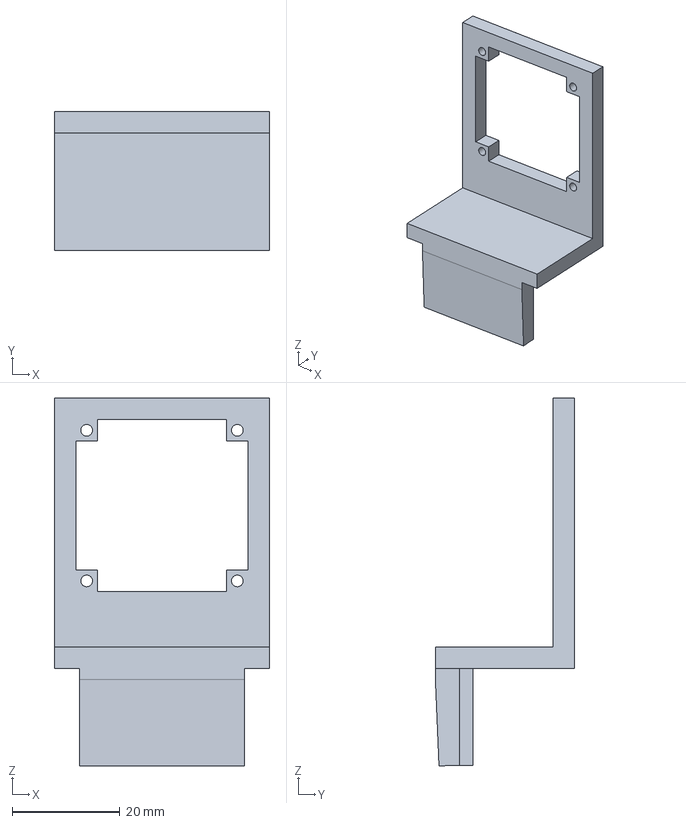
[picture p22: CAD file, 2026-10-09]
hardware/camera-mounts/data-collection-camera-mounts/V1/mount-3-4-adapter.stp
40.0 x 25.9 x 68.4 mm
