Seeed-Projects/reBot-DevArm/Rebot_Arm_description/Camera/meshes/mounts/D435_Gemini2_Mount.stl

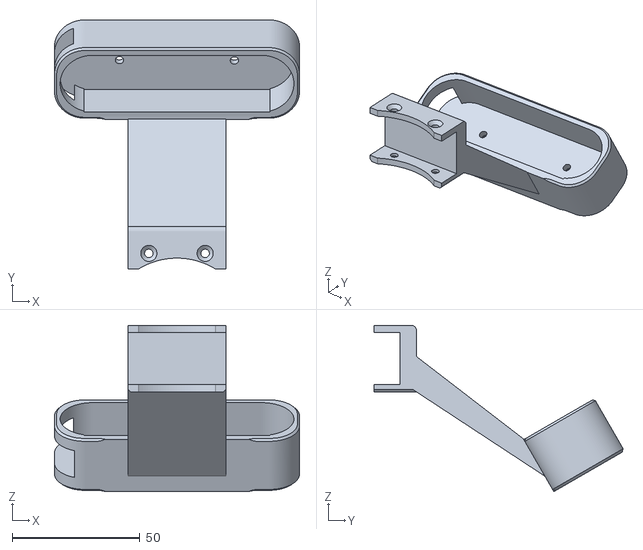
[picture p23: CAD file, 2026-10-09]
Rebot_Arm_description/Camera/meshes/mounts/D435_Gemini2_Mount.stl
95.8 x 97.4 x 65.0
