Seeed-Projects/reBot-DevArm/Rebot_Arm_description/Camera/meshes/uvc32/lens.stl

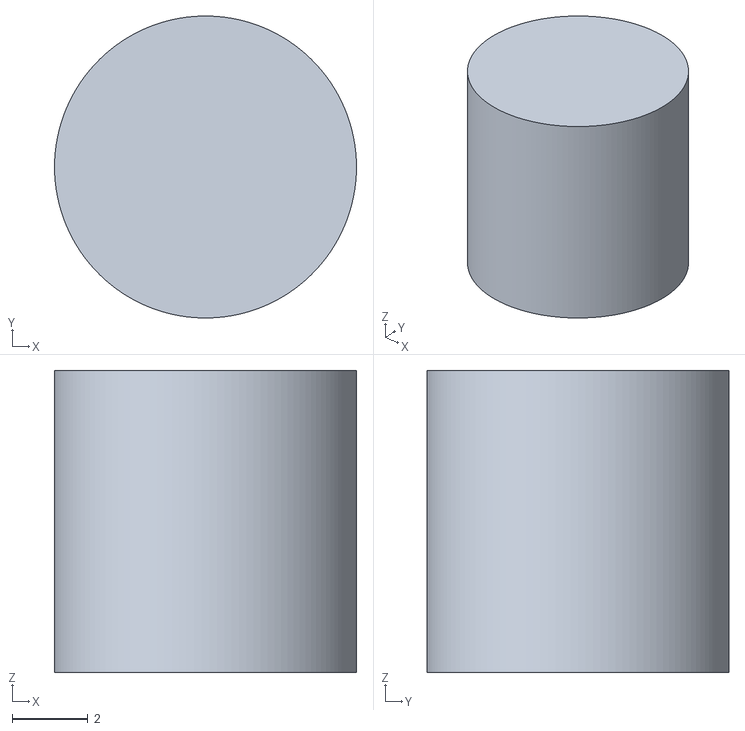
[picture p24: CAD file, 2026-10-09]
Rebot_Arm_description/Camera/meshes/uvc32/lens.stl
8.00 x 8.00 x 8.00
