Seeed-Projects/reBot-DevArm/hardware/camera-mounts/b601-camera-mounts/V1/UVC32_mount.step

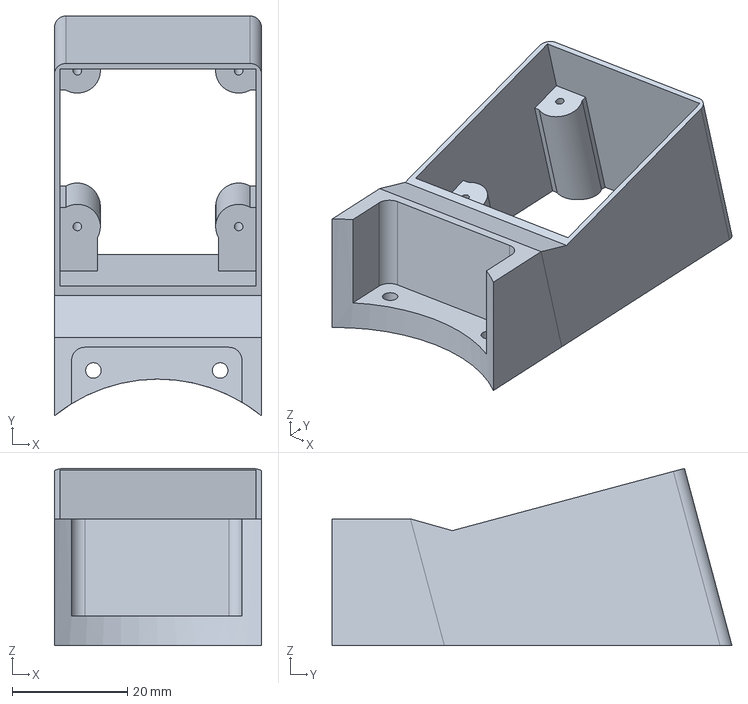
[picture p25: CAD file, 2026-11-11]
hardware/camera-mounts/b601-camera-mounts/V1/UVC32_mount.step
36.0 x 69.4 x 30.8 mm
