Seeed-Projects/reBot-DevArm/hardware/camera-mounts/data-collection-camera-mounts/V1/mount-2-soarm-adapter.stp

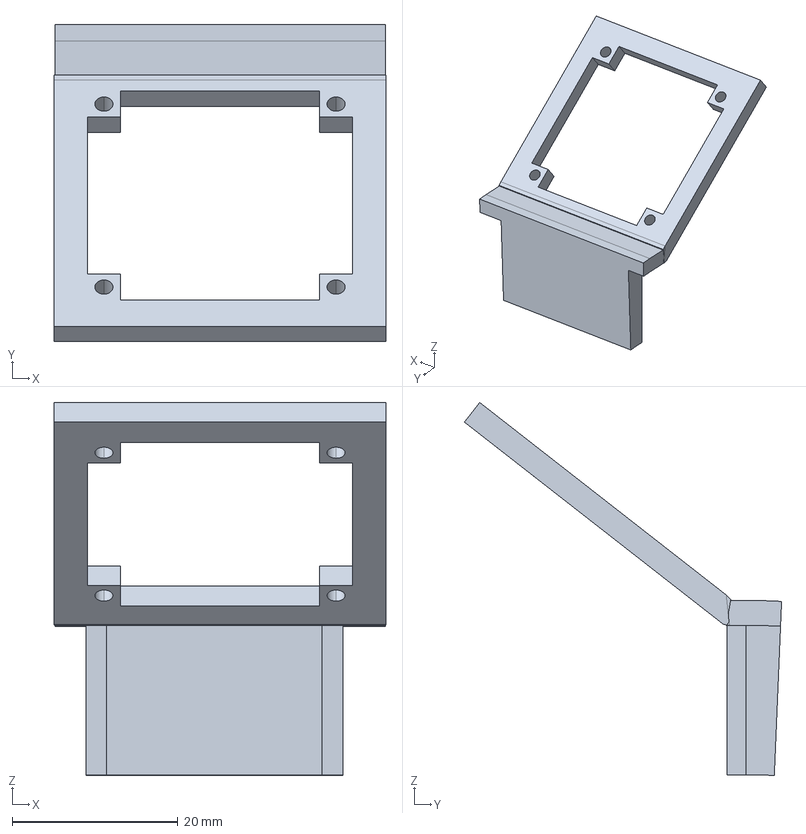
[picture p26: CAD file, 2026-10-09]
hardware/camera-mounts/data-collection-camera-mounts/V1/mount-2-soarm-adapter.stp
40.0 x 38.3 x 45.0 mm
