Seeed-Projects/reBot-DevArm/Rebot_Arm_description/Camera/meshes/mounts/D405_305_Mount.stl

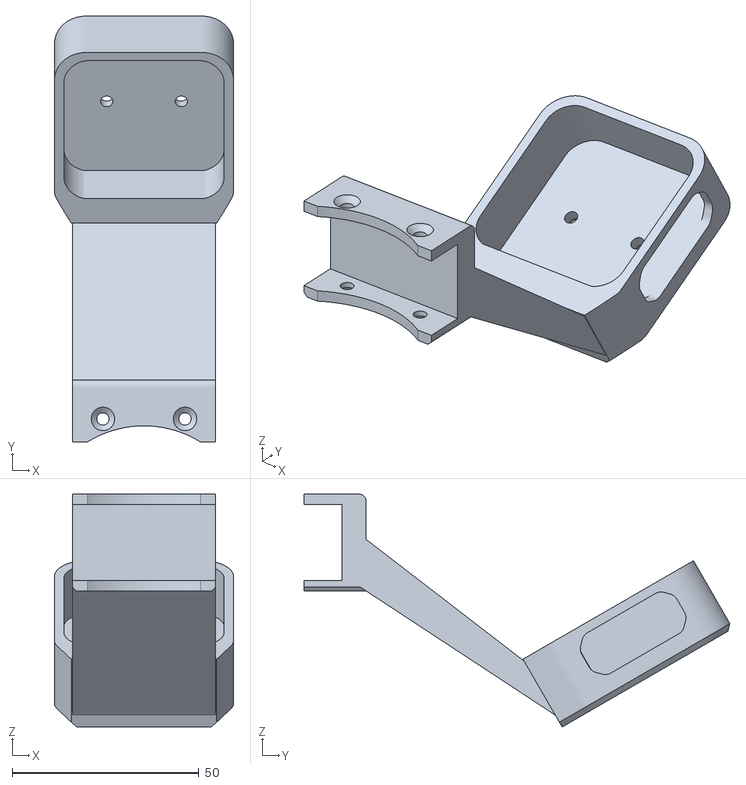
[picture p27: CAD file, 2026-10-09]
Rebot_Arm_description/Camera/meshes/mounts/D405_305_Mount.stl
48.0 x 114.2 x 62.5
