Seeed-Projects/reBot-DevArm/Rebot_Arm_description/Camera/meshes/uvc32/board.stl

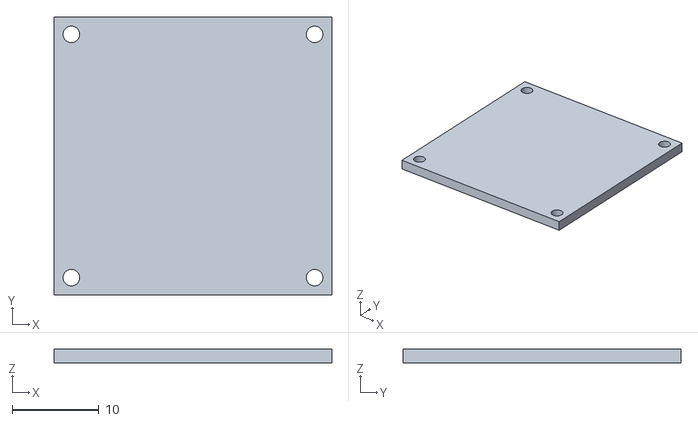
[picture p28: CAD file, 2026-10-09]
Rebot_Arm_description/Camera/meshes/uvc32/board.stl
32.0 x 32.0 x 1.60
