Seeed-Projects/reBot-DevArm/hardware/camera-mounts/data-collection-camera-mounts/V1/mount-4.stp

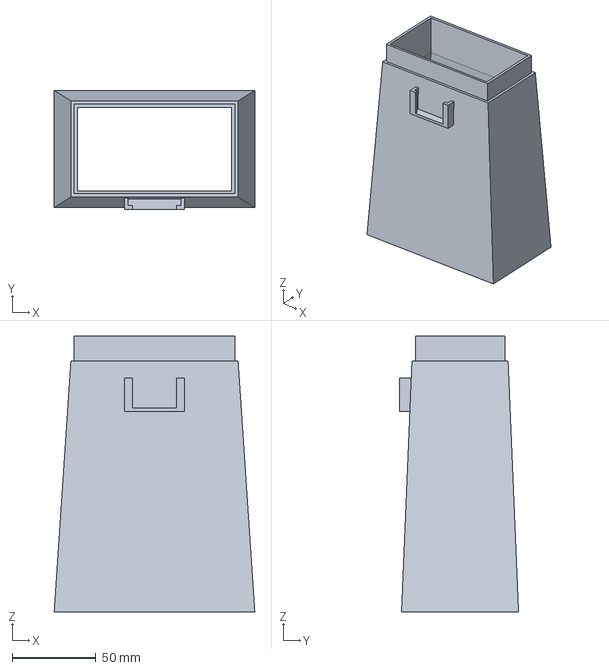
[picture p29: CAD file, 2026-10-09]
hardware/camera-mounts/data-collection-camera-mounts/V1/mount-4.stp
120.0 x 71.2 x 165.0 mm
