Seeed-Projects/reBot-DevArm/hardware/camera-mounts/data-collection-camera-mounts/V1/mount-2.stp

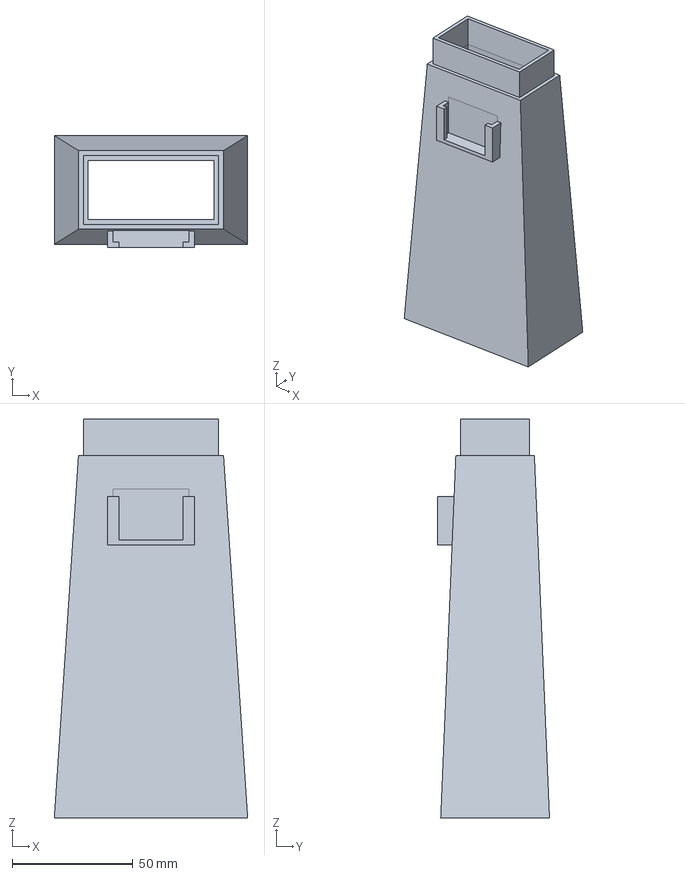
[picture p30: CAD file, 2026-10-09]
hardware/camera-mounts/data-collection-camera-mounts/V1/mount-2.stp
80.0 x 46.3 x 165.0 mm
