Seeed-Projects/reBot-DevArm/Rebot_Arm_description/Camera/meshes/gemini2/base_link.STL

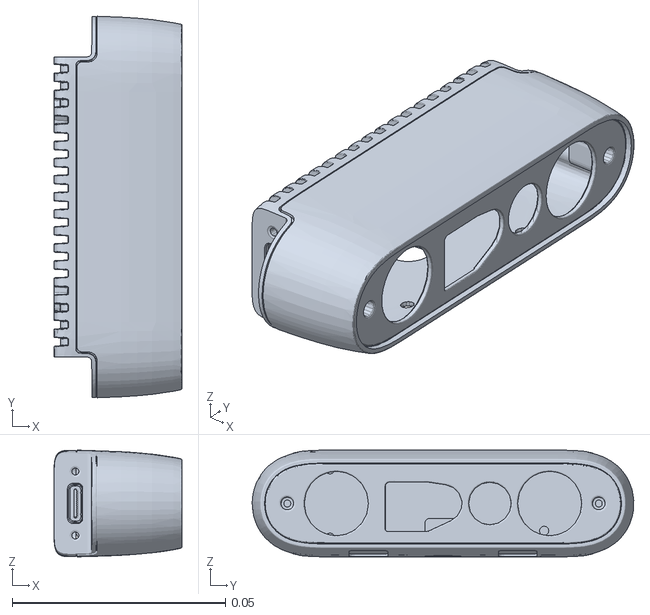
[picture p31: CAD file, 2026-10-09]
Rebot_Arm_description/Camera/meshes/gemini2/base_link.STL
0.03 x 0.0894 x 0.025
