Seeed-Projects/reBot-DevArm/hardware/camera-mounts/data-collection-camera-mounts/V1/mount-3.stp

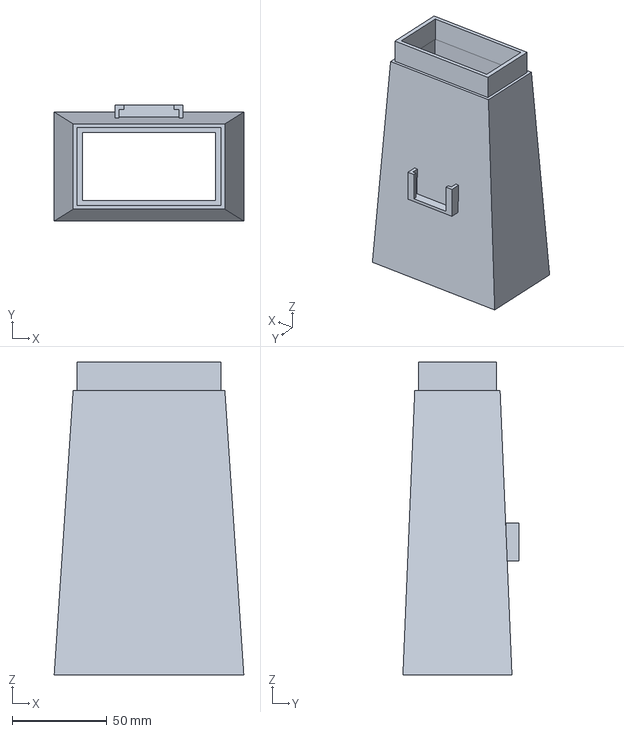
[picture p32: CAD file, 2026-10-09]
hardware/camera-mounts/data-collection-camera-mounts/V1/mount-3.stp
100.0 x 61.2 x 165.0 mm
