Seeed-Projects/reBot-DevArm/Rebot_Arm_description/Camera/meshes/gemini2/camera_color_frame.STL

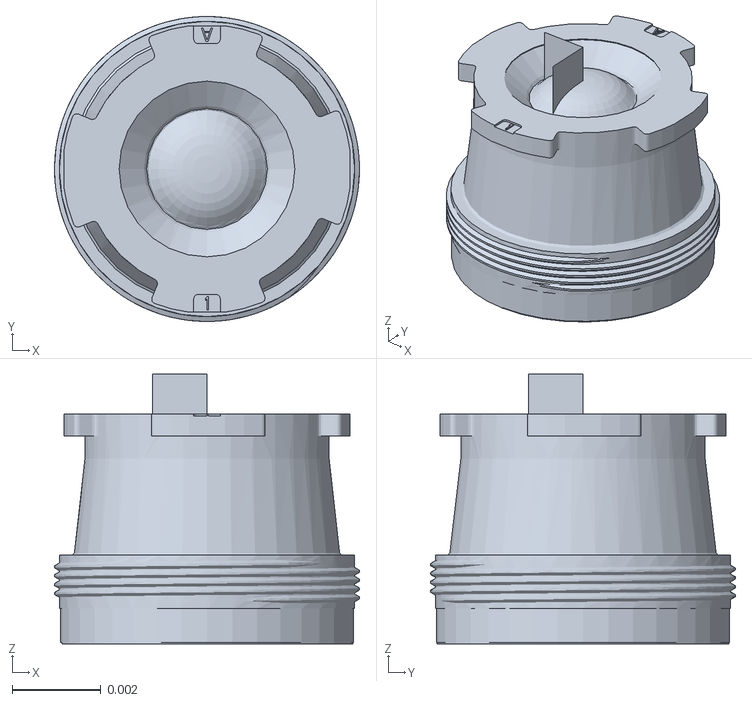
[picture p33: CAD file, 2026-10-09]
Rebot_Arm_description/Camera/meshes/gemini2/camera_color_frame.STL
0.00687 x 0.00687 x 0.00608
