Seeed-Projects/reBot-DevArm/hardware/camera-mounts/data-collection-camera-mounts/V1/mount-1-rebot-adapter.stp

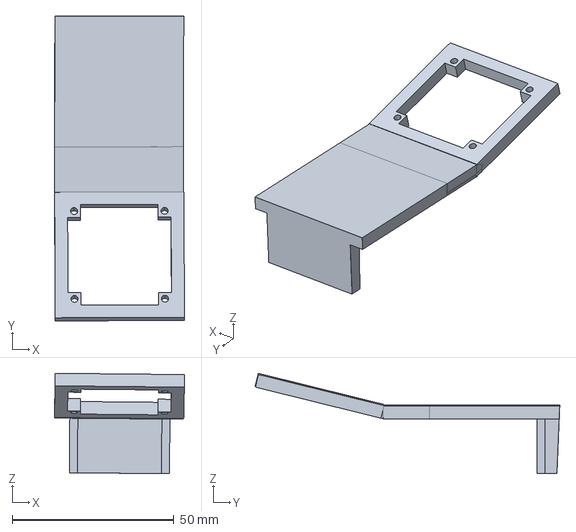
[picture p34: CAD file, 2026-10-09]
hardware/camera-mounts/data-collection-camera-mounts/V1/mount-1-rebot-adapter.stp
40.2 x 94.3 x 31.1 mm
