Seeed-Projects/reBot-DevArm/hardware/camera-mounts/data-collection-camera-mounts/V1/mount-1-soarm-adapter.stp

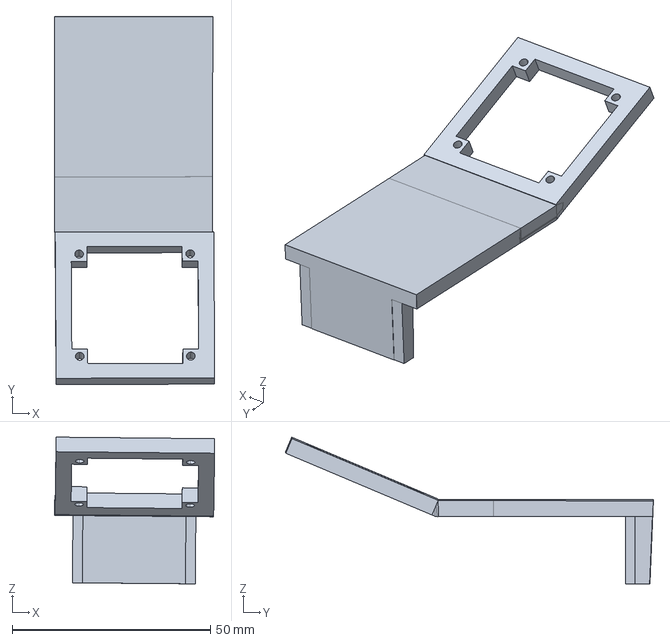
[picture p35: CAD file, 2026-10-09]
hardware/camera-mounts/data-collection-camera-mounts/V1/mount-1-soarm-adapter.stp
40.5 x 92.8 x 37.0 mm
