Seeed-Projects/reBot-DevArm/(list of files, cad)

Other CAD files:
Rebot_Arm_description/Camera/meshes/gemini2/camera_depth_frame.STL
Rebot_Arm_description/Camera/meshes/gemini2/camera_infra2_frame.STL
Rebot_Arm_description/Camera/meshes/gemini2/camera_infra1_frame.STL
Rebot_Arm_description/Camera/meshes/gemini2/camera_botter_screw_frame.STL
Rebot_Arm_description/Camera/source/seeed_projects/hardware/camera-mounts/b601-camera-mounts/D435_Gemini2_Mount.step
Rebot_Arm_description/Camera/source/seeed_projects/hardware/camera-mounts/b601-camera-mounts/UVC32_mount.step
