Seeed-Projects/reBot-DevArm/assets/star-history/star-history.png

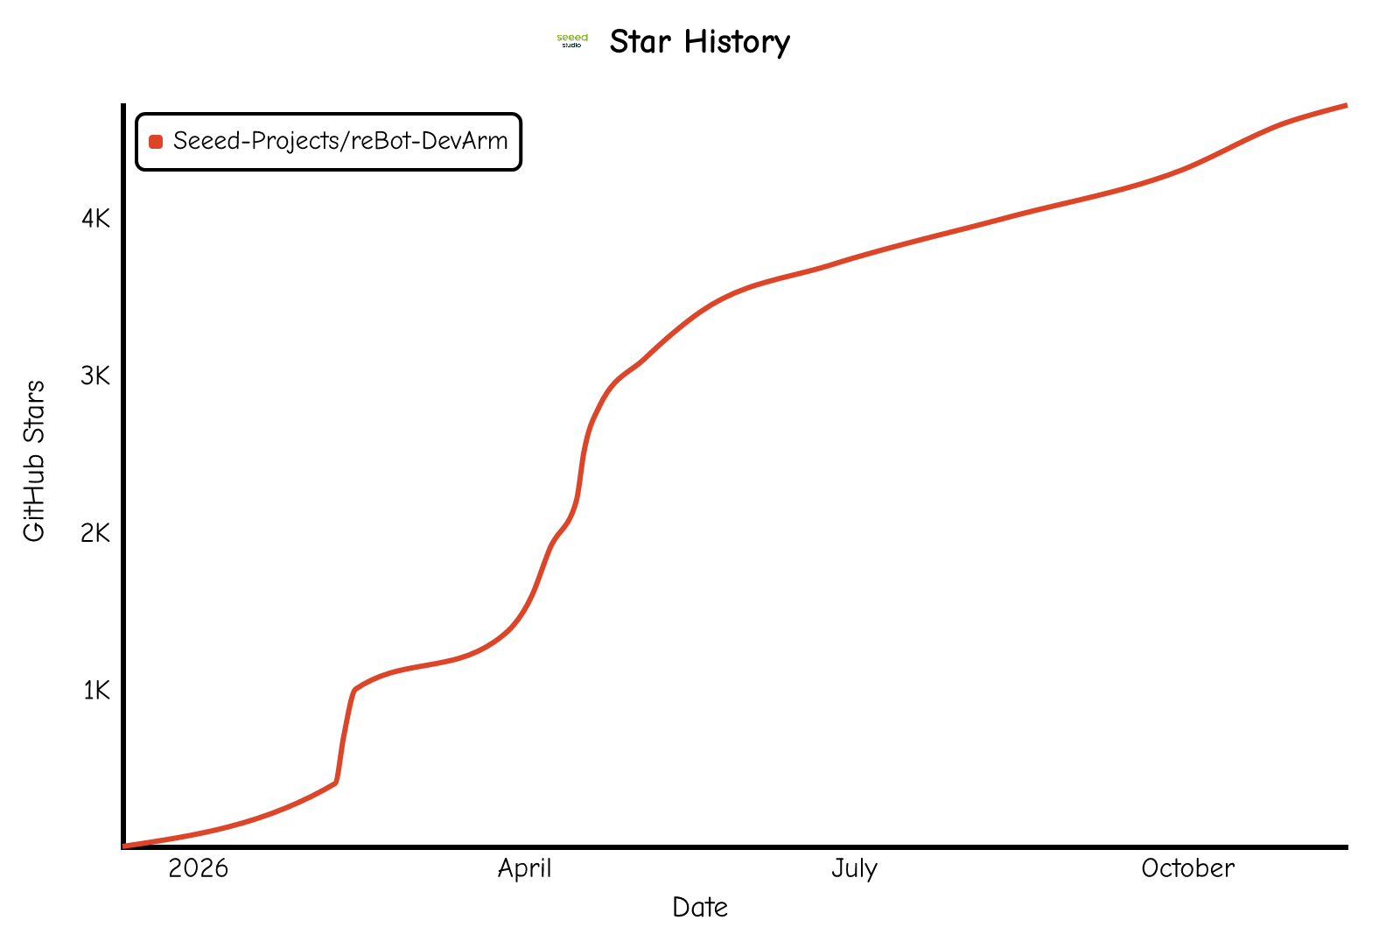
assets/star-history/star-history.png
