Seeed-Projects/reBot-DevArm/(commit log)

2026-09-04 ci: stop the link check failing on transient network errors
    Run 33466366735 failed on the #71 branch over a network error rather
    than a broken link, and #71 was merged three minutes later. Merging was
    correct — main checks clean today, and that PR added no external links
    at all — but a check that goes red for reasons unrelated to the pull
    request is a check people learn to dismiss, and the next genuine 404
    gets the same three-minute dismissal.
    - --accept-timeouts: a host that does not answer within the timeout says
    nothing about whether the link is dead. A delisted product still
    answers 404, and that still fails the build, which is the whole point
    of the job. Available in the rele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
2026-09-08 docs: restore D405 mount design notes in all README languages
    Restore the versioned design-notes links introduced in #69 and lost in subsequent README merges.
2026-10-09 Add D405, D435i and Gemini 2 wrist camera descriptions
    [D405_305_Mount.stl, D435_Gemini2_Mount.stl, _d405.urdf.xacro, _d435.urdf.xacro, _d435i.urdf.xacro, _d435i_imu_modules.urdf.xacro, _materials.urdf.xacro, _usb_plug.urdf.xacro]
2026-10-09 docs: clarify shared RS and DM wrist camera assemblies
2026-10-09 Add UVC32 wrist camera assets and update official assembly previews
    [D435_Gemini2_Mount.step, UVC32_mount.step, UVC32_mount.stl, board.stl, glass.stl, lens.stl, rebotarm_rs_with_uvc32.urdf.xacro, uvc32.urdf]
2026-10-09 Add V2 data collection camera mount and organize V1 assets
    [data-collection-camera-mount-v2.stp, mount-1-rebot-adapter.stp, mount-1-soarm-adapter.stp, mount-1.stp, mount-2-soarm-adapter.stp, mount-2.stp, mount-3-4-adapter.stp, mount-3.stp]
2026-10-29 Add Amogh/菊地あかね showcases, kit purchase links, and accessories section
    - Add Amogh Shrivastava and 菊地あかね to Community Showcase in all 5 READMEs
    - Link each B601-DM / B601-RS kit option to its SeeedStudio product page
    - Add Optional Accessories section: power adapter kits, discharge/bleeder
    protection modules, and soft gripper for both models
2026-10-30 B601-DM: update 20260625 assembly STEP; harness upgrade and bracket tweaks
    - All wire harnesses replaced with injection-molded custom harnesses
    - Forearm and wrist 3D-printed brackets fine-tuned so cables pass
    through the routing holes
    - Changelog added to all five hardware readme languages
2026-11-10 Remove incorrect D455f camera mount
2026-11-11 Archive historical B601 camera mounts as V1
2026-11-13 Promote the bimanual reBot Arm T701 across all README languages
    Add a header link, a table-of-contents entry, and a dedicated section
    after the Introduction pointing to the new open-source bimanual platform
    https://github.com/Seeed-Projects/reBot-Arm-T701
2026-11-13 Fix broken in-page anchor links in all README languages
    Emoji headings produce anchors with a leading hyphen (and a U+FE0F
    variation selector for 🗺️/⚙️), so the old TOC and badge targets never
    matched. Rebuilt every link from the anchors GitHub actually generates
    (verified via the Markdown API): 14 links fixed per file.
