Seeed-Projects/reBot-DevArm/(notices)

Notices in the files:
README.md:
Hardware License: CERN-OHL-W-2.0
Software License: Apache-2.0
